rustbox/router/SYZYGY-breakout/README.md

# SYZYGY Breakout

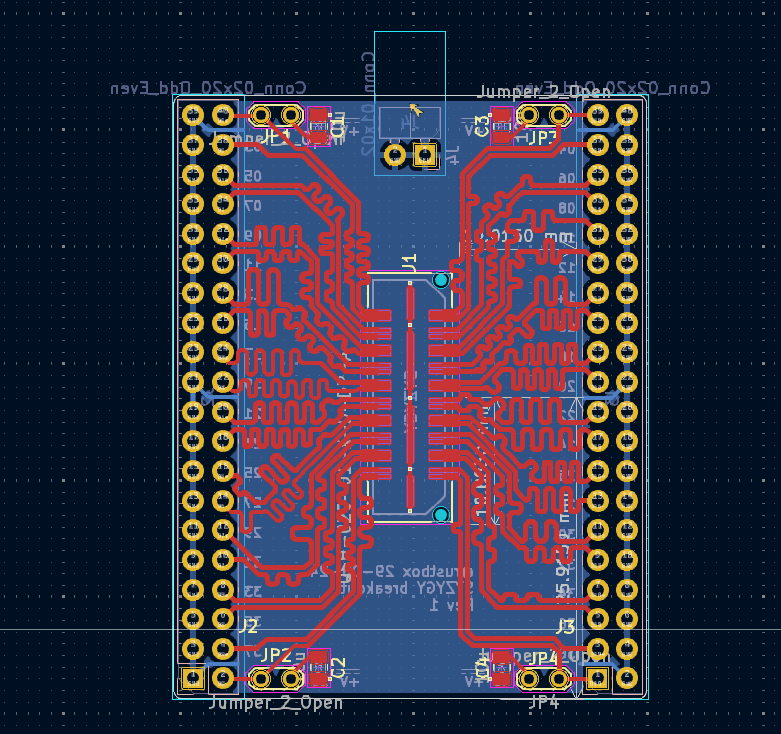
[picture p5: SYZYGY-breakout/images/SYZYGY-breakout-PCB.png]


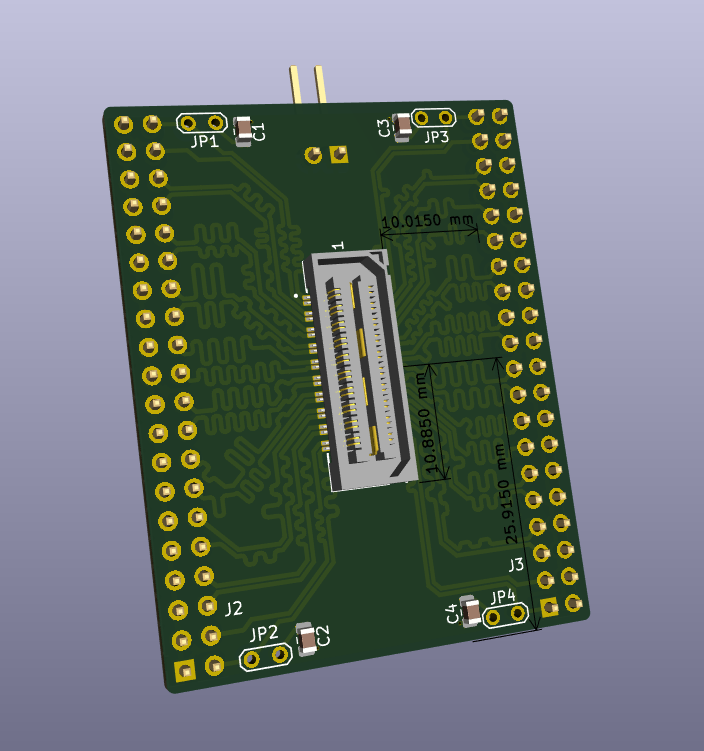
[picture p6: SYZYGY-breakout/images/SYZYGY-breakout-PCB-render.png]


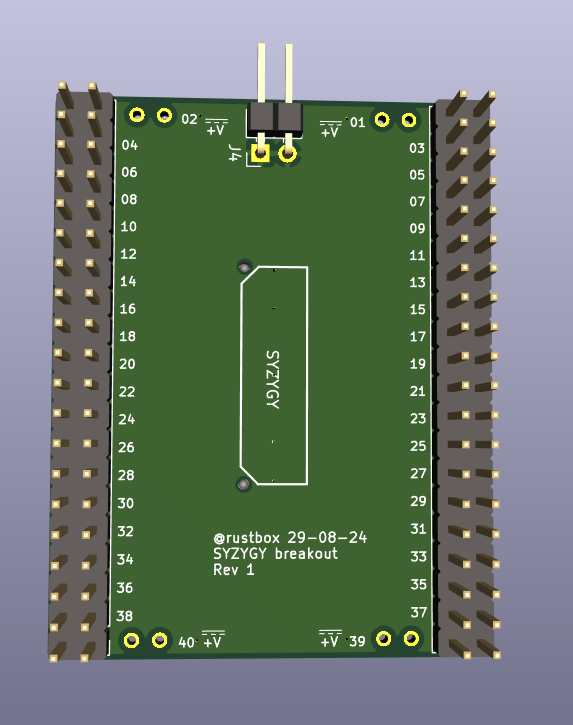
[picture p7: SYZYGY-breakout/images/SYZYGY-breakout-PCB-render-front.png]
