rustbox/router/HSEC8-109-01-L-RA-TR/HSEC8-109-01-L-RA-TR.step

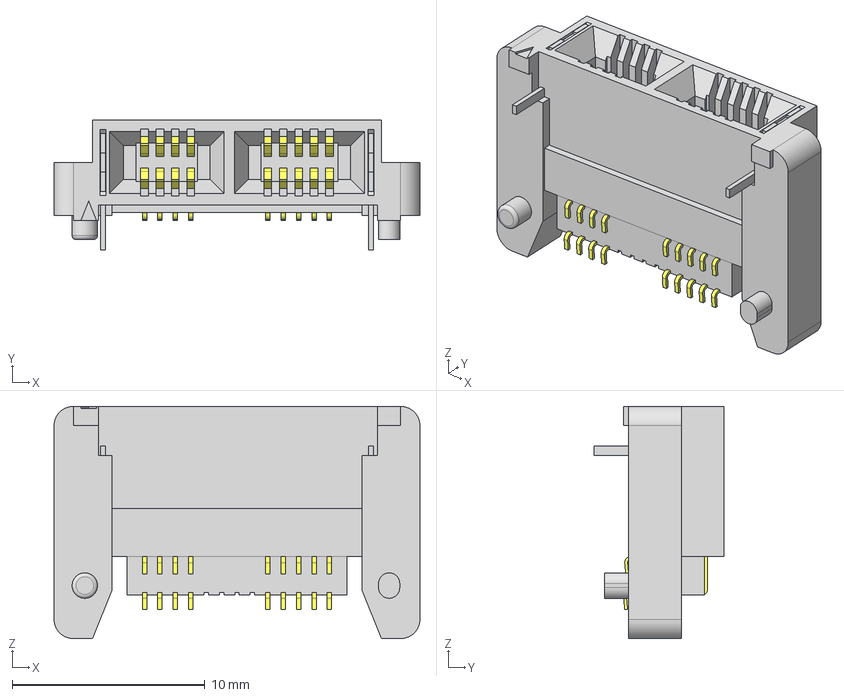
[picture p8: CAD file, 2024-07-10]
HSEC8-109-01-L-RA-TR/HSEC8-109-01-L-RA-TR.step
19.0 x 6.74 x 12.1 mm
HSEC8-09-01-D-RA-_socket
C-272-09
