rustbox/router/local/QSH-020-01-F-D-DP-A.stp

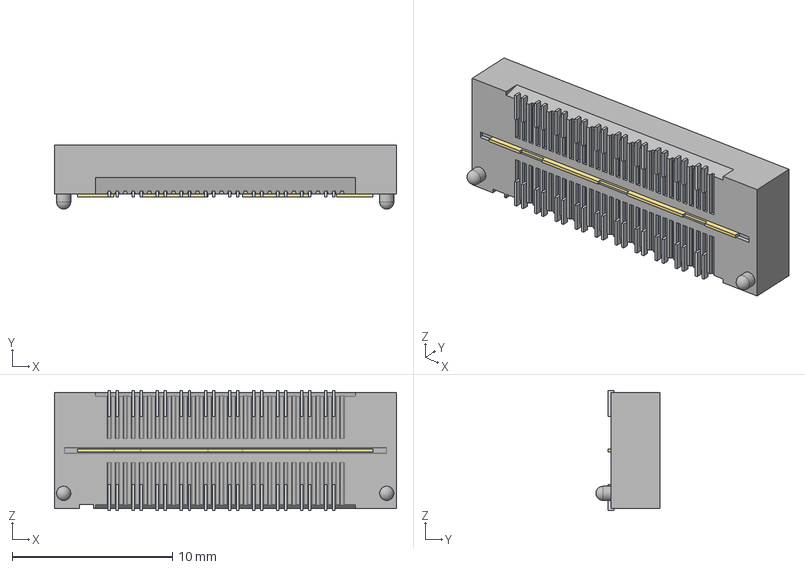
[picture p9: CAD file, 2024-08-29]
local/QSH-020-01-F-D-DP-A.stp
21.3 x 4.00 x 7.49 mm
TQSH-020-01-D-DP-A_terminal
T-1G2-01-020
C-126-21-020-D-DP-F
C-126-21-020-D-DP-F2
