rustbox/router/local/TXV0106BQBR.stp

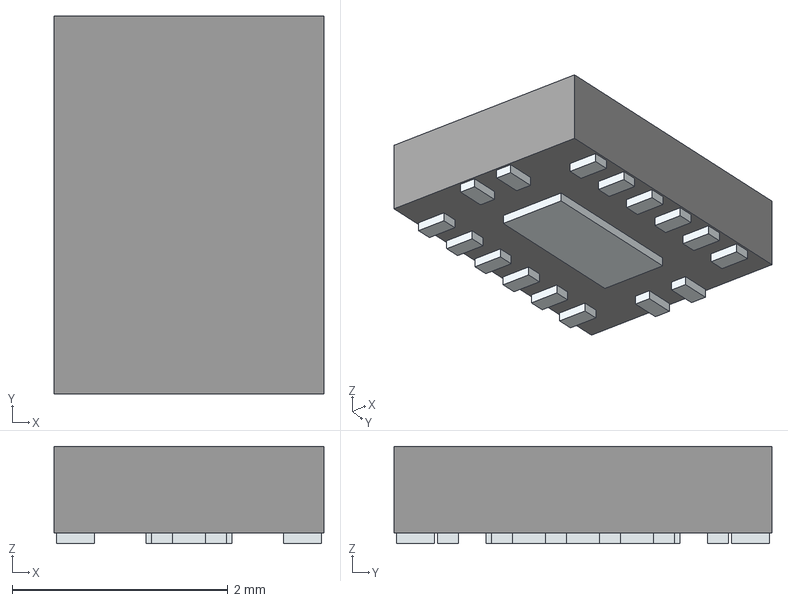
[picture p10: CAD file, 2024-08-16]
local/TXV0106BQBR.stp
2.50 x 3.50 x 0.9 mm
Pins
