rustbox/router/local/QTH-020-01-X-D-DP-A.step

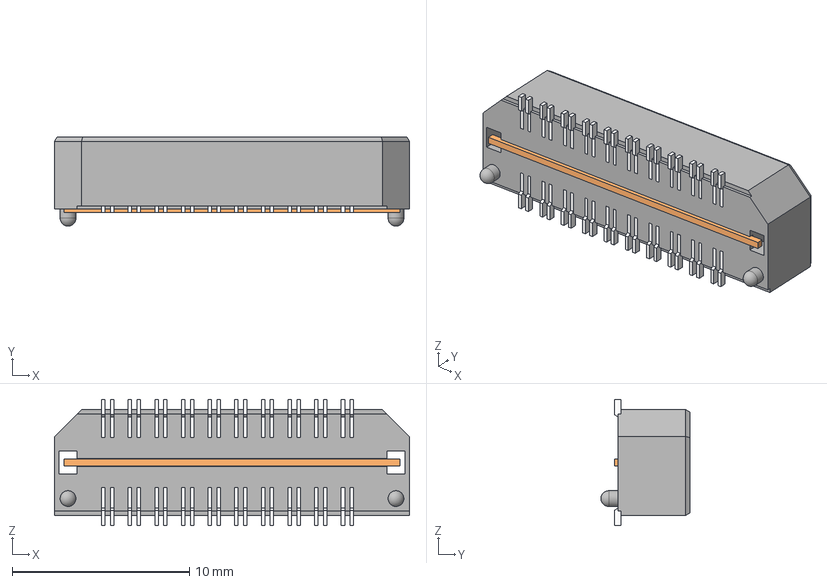
[picture p11: CAD file, 2024-08-07]
local/QTH-020-01-X-D-DP-A.step
20.0 x 5.03 x 7.11 mm
TQTH-020-01-F-D-DP-A_terminal
T-1S39-01(-020-01-D-DP-F)_pin
T-1S39-01(-020-01-D-DP)_pin2
T-1G1-01_imp
