rustbox/router/local/GPY111.stp

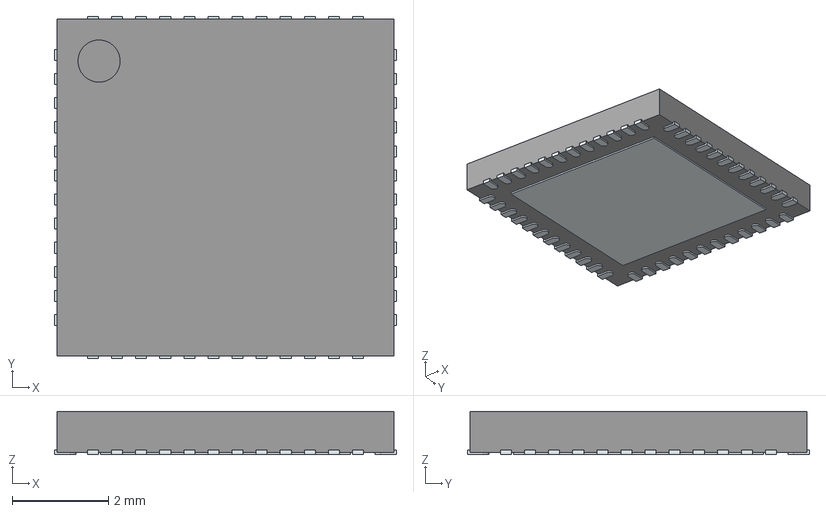
[picture p12: CAD file, 2024-08-07]
local/GPY111.stp
7.10 x 7.10 x 0.9 mm
ThermalPin
PinsArrayLR
PinsArrayTB
