rustbox/router/local/AP7363-HA-7.stp

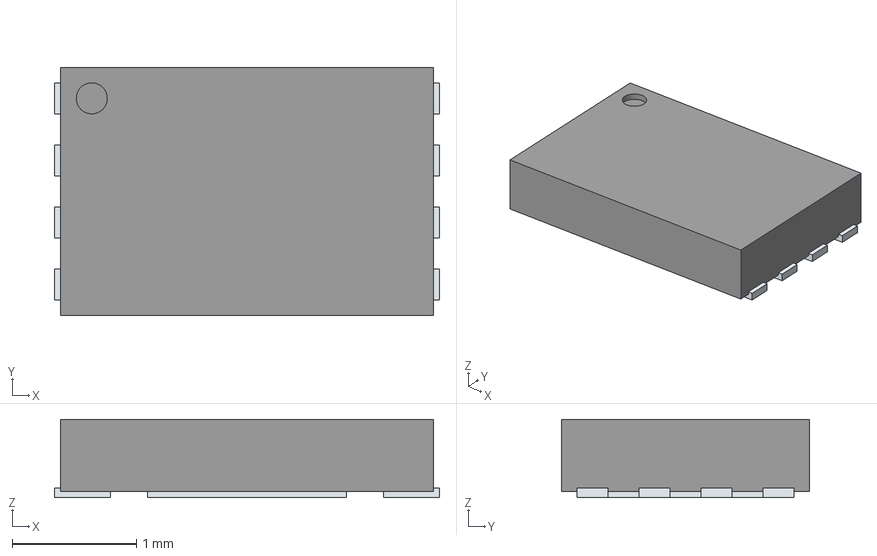
[picture p13: CAD file, 2024-08-07]
local/AP7363-HA-7.stp
3.10 x 2.00 x 0.63 mm
ThermalPin
PinsArrayLR
