rustbox/router/local/TS21-34-035-BK-160-SMT-TR.stp

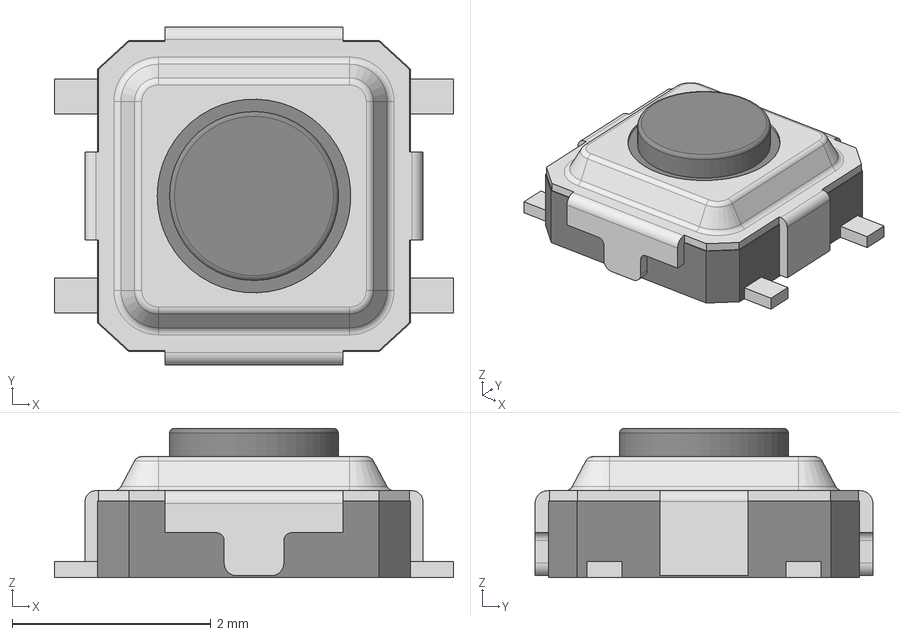
[picture p14: CAD file, 2024-07-10]
local/TS21-34-035-BK-160-SMT-TR.stp
4.02 x 3.40 x 1.50 mm
