rustbox/router/local/1149848.stp

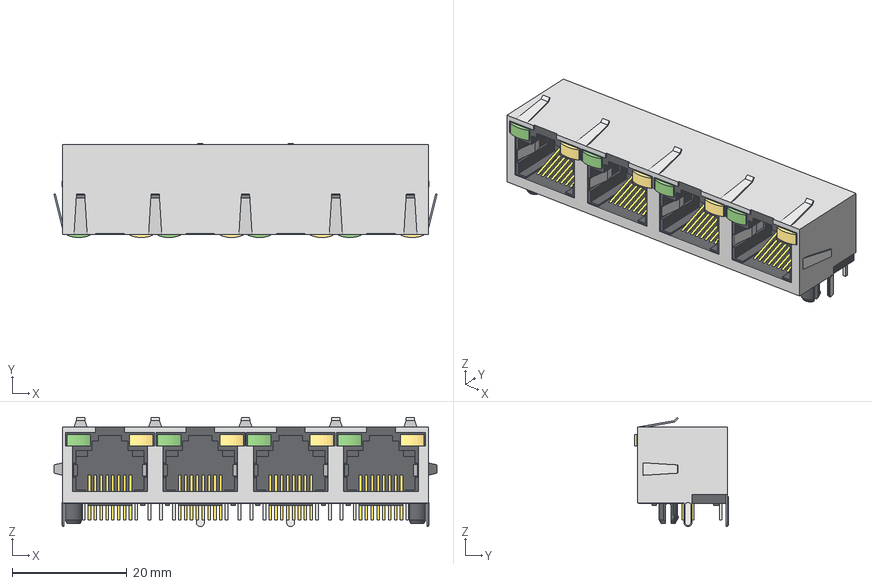
[picture p15: CAD file, 2024-07-10]
local/1149848.stp
66.8 x 16.4 x 19.0 mm
