rustbox/router/local/TPS564247DRLR.stp

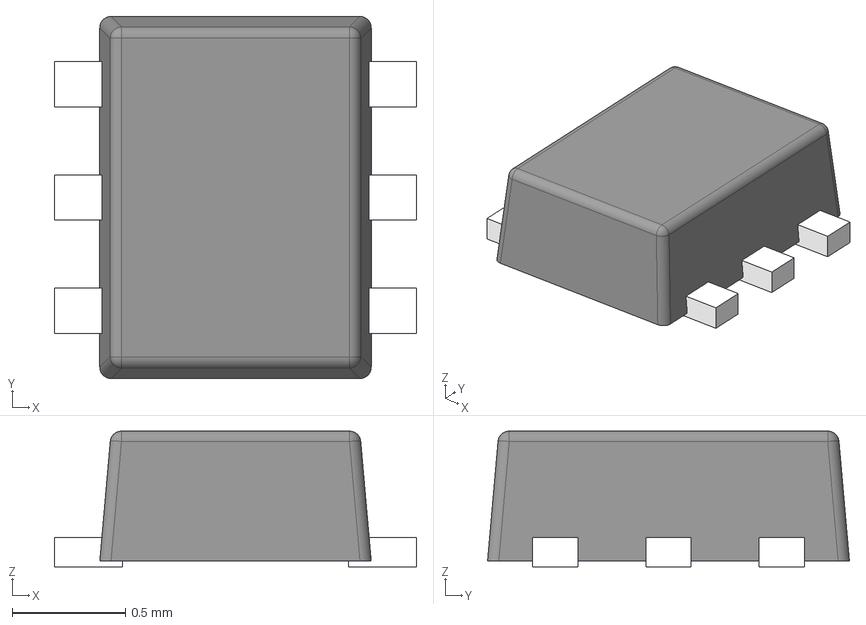
[picture p16: CAD file, 2024-07-10]
local/TPS564247DRLR.stp
1.60 x 1.60 x 0.6 mm
FRAME-DRL0006A
BODY-SOT
PIN1-ID
