rustbox/router/SYZYGY-PHY/SYZYGY-PHY-schematic.pdf

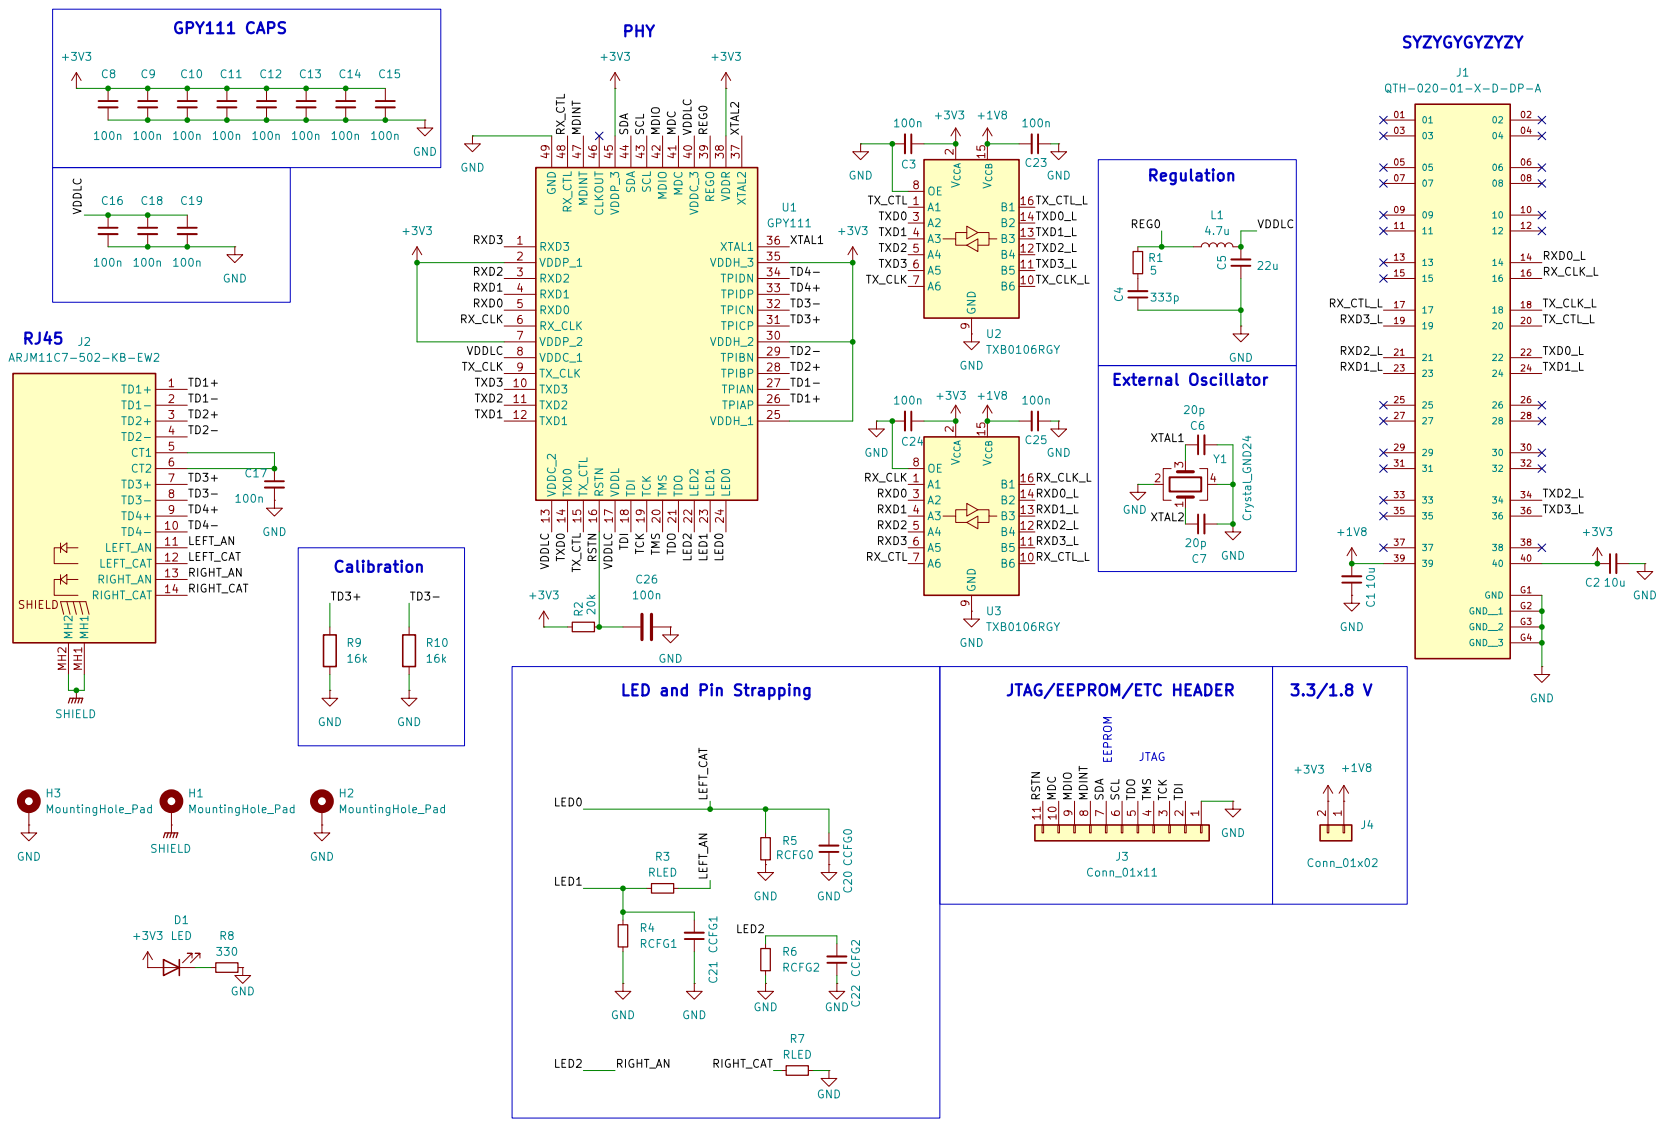
[picture p17: page 1]
