rustbox/router/SYZYGY-PHY/SYZYGY-PHY.kicad_pcb

## KiCad design SYZYGY-PHY/SYZYGY-PHY.kicad_pcb (2024-10-03)

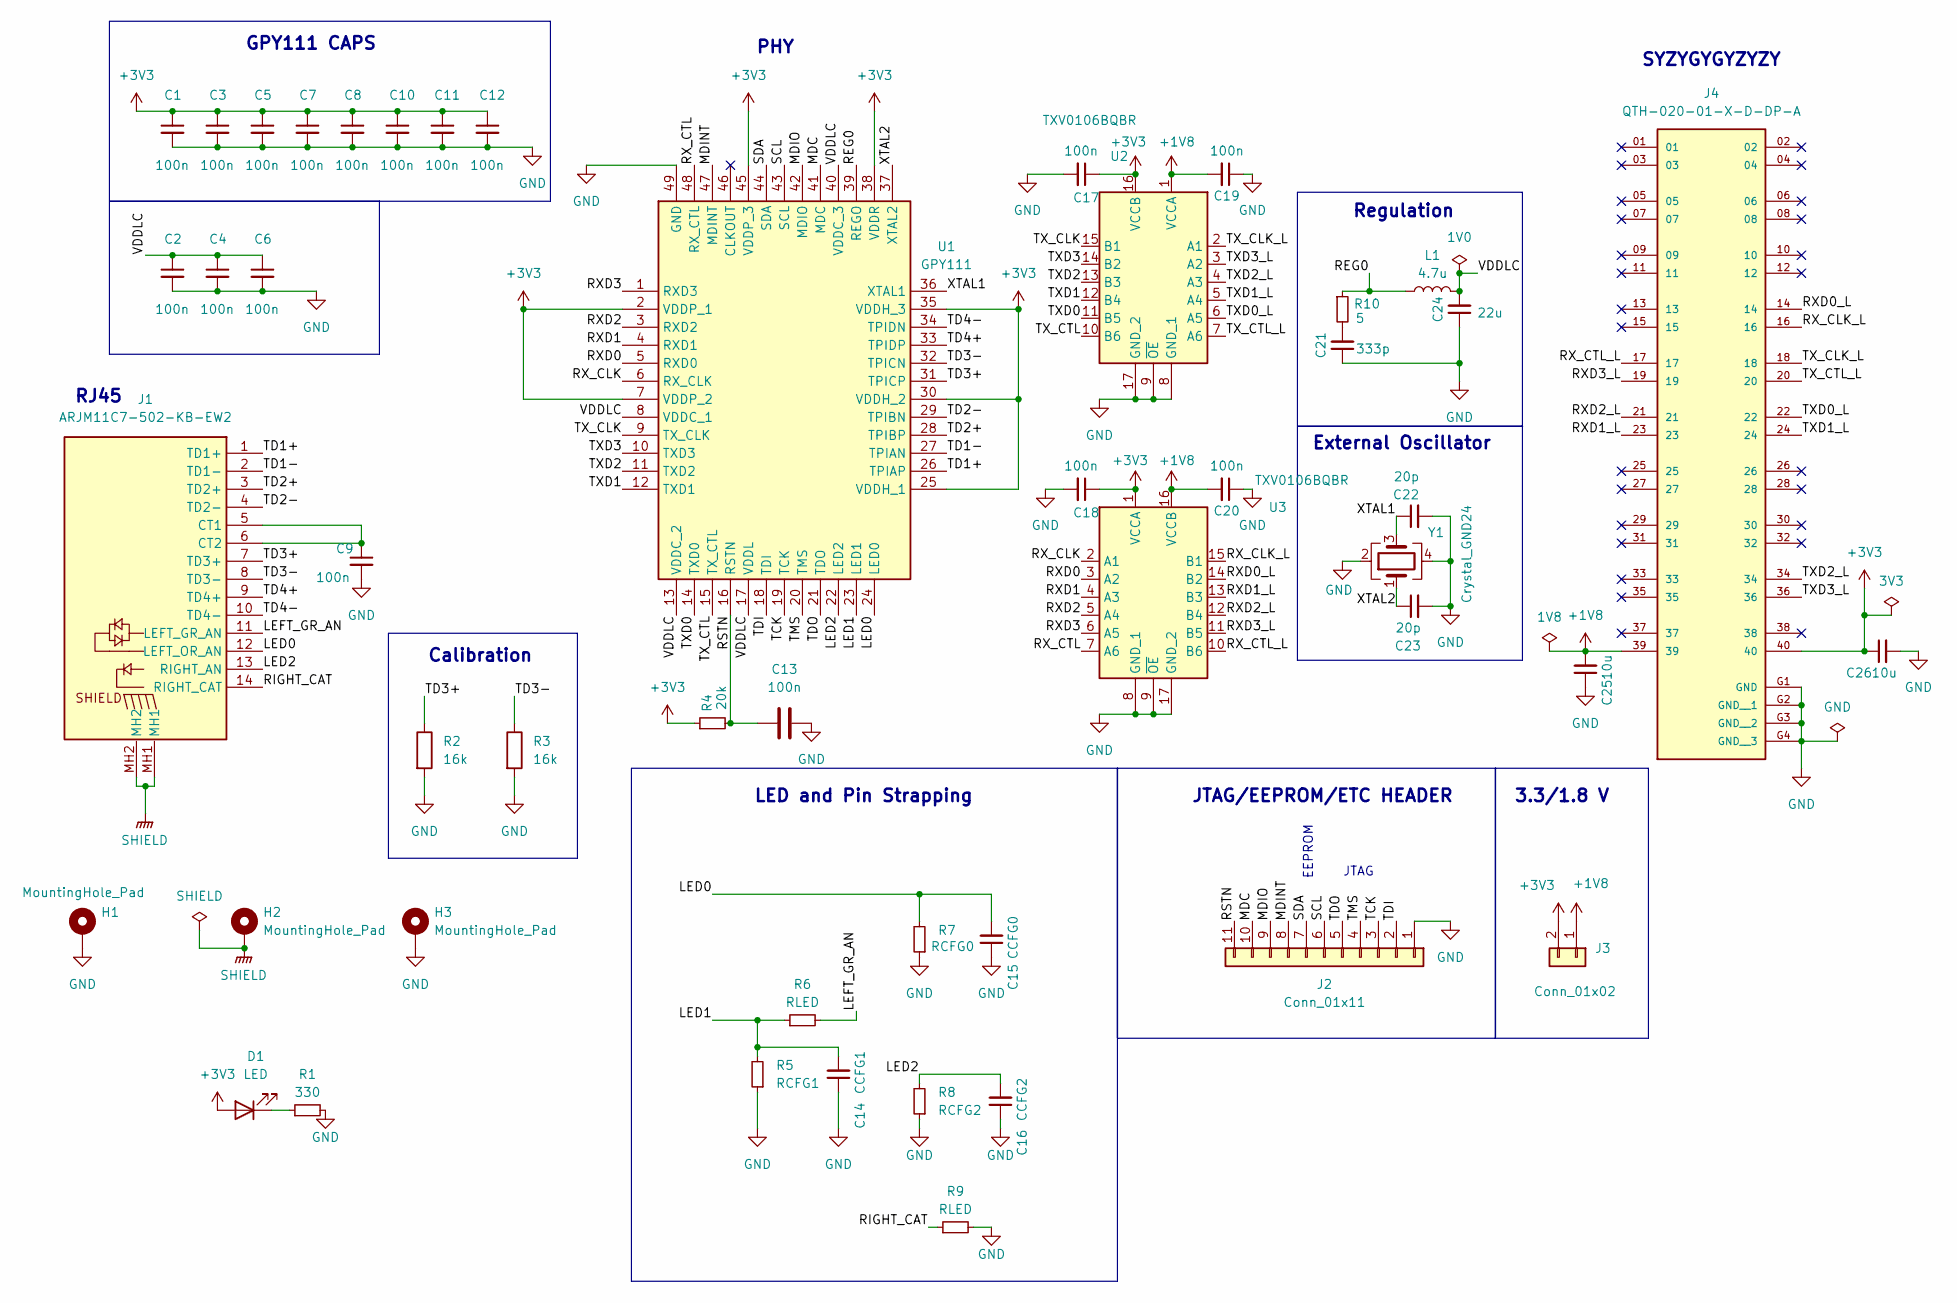
[picture p18: schematic SYZYGY-PHY.kicad_sch]

Parts:
C1, C2, C3, C4, C5, C6, C7, C8, C9, C10, C11, C12, C13, C17, C18, C19, C20: 100n; C_0805_2012Metric_Pad1.18x1.45mm_HandSolder
C14: CCFG1; C_0805_2012Metric_Pad1.18x1.45mm_HandSolder
C15: CCFG0; C_0805_2012Metric_Pad1.18x1.45mm_HandSolder
C16: CCFG2; C_0805_2012Metric_Pad1.18x1.45mm_HandSolder
C21: 333p; C_0805_2012Metric_Pad1.18x1.45mm_HandSolder
C22, C23: 20p; C_0805_2012Metric_Pad1.18x1.45mm_HandSolder
C24: 22u; C_0805_2012Metric_Pad1.18x1.45mm_HandSolder
C25, C26: 10u; C_0805_2012Metric_Pad1.18x1.45mm_HandSolder
D1: LED; LED_0805_2012Metric; Mouser # 710-150080VS75000
H1, H2, H3: MountingHole_Pad; MountingHole_2.7mm_M2.5_Pad
J1: ARJM11C7-502-KB-EW2; ARJM11C7502KBEW2; Mouser Part Number 815-RJM11C7502KBEW2
J2: Conn_01x11; PinSocket_1x11_P2.54mm_Vertical; Mouser # 538-22-15-2116
J3: Conn_01x02; PinHeader_1x02_P2.54mm_Vertical
J4: QTH-020-01-X-D-DP-A; SAMTEC_QTH-020-01-X-D-DP-A; PARTREV L; Mouser # 200-QTH02001LDDPA
L1: 4.7u; Inductor 0806 (2016 metric); Part MAKK2016T4R7M
R1: 330; R_0805_2012Metric_Pad1.20x1.40mm_HandSolder
R2: 16k; R_0805_2012Metric_Pad1.20x1.40mm_HandSolder; Mouser # 667-ERJ-6ENF1602V
R3: 16k; R_0805_2012Metric_Pad1.20x1.40mm_HandSolder
R4: 20k; R_0805_2012Metric_Pad1.20x1.40mm_HandSolder
R5: RCFG1; R_0805_2012Metric_Pad1.20x1.40mm_HandSolder
R6, R9: RLED; R_0805_2012Metric_Pad1.20x1.40mm_HandSolder
R7: RCFG0; R_0805_2012Metric_Pad1.20x1.40mm_HandSolder
R8: RCFG2; R_0805_2012Metric_Pad1.20x1.40mm_HandSolder
R10: 5; R_0805_2012Metric_Pad1.20x1.40mm_HandSolder
U1: GPY111; QFN50P700X700X90-49N-D; Mouser Part Number 701-GPY111
U2, U3: TXV0106BQBR; Mouser Part Number 595-TXV0106BQBR
Y1: Crystal_GND24; Crystal_SMD_3225-4Pin_3.2x2.5mm_HandSoldering; Manufacturer # TSX-3225 25.0000MF18X-G0; Mouser 732-TSX-322MF18X-G

Connections:
+1V8: C19.2, C20.2, C25.2, J3.1, J4.39, U2.1 (VCCA), U3.16 (VCCB)
+3V3: C1.1, C3.1, C5.1, C7.1, C8.1, C10.1, C11.1, C12.1, C17.1, C18.1, C26.1, D1.2 (A), J3.2, J4.40, R4.1, U1.2 (VDDP_1), U1.7 (VDDP_2), U1.25 (VDDH_1), U1.30 (VDDH_2), U1.35 (VDDH_3), U1.38 (VDDR), U1.45 (VDDP_3), U2.16 (VCCB), U3.1 (VCCA)
/LED0: C15.2, J1.12 (LEFT_OR_AN), R7.2, U1.24 (LED0)
/LED1: C14.2, R5.2, R6.1, U1.23 (LED1)
/LED2: C16.2, J1.13 (RIGHT_AN), R8.2, U1.22 (LED2)
/LEFT_GR_AN: J1.11 (LEFT_GR_AN), R6.2
/MDC: J2.10, U1.41 (MDC)
/MDINT: J2.8, U1.47 (MDINT)
/MDIO: J2.9, U1.42 (MDIO)
/REG0: L1.1, R10.1, U1.39 (REGO)
/RIGHT_CAT: J1.14 (RIGHT_CAT), R9.1
/RSTN: C13.2, J2.11, R4.2, U1.16 (RSTN)
/RXD0: U1.5 (RXD0), U3.3 (A2)
/RXD0_L: J4.14, U3.14 (B2)
/RXD1: U1.4 (RXD1), U3.4 (A3)
/RXD1_L: J4.23, U3.13 (B3)
/RXD2: U1.3 (RXD2), U3.5 (A4)
/RXD2_L: J4.21, U3.12 (B4)
/RXD3: U1.1 (RXD3), U3.6 (A5)
/RXD3_L: J4.19, U3.11 (B5)
/RX_CLK: U1.6 (RX_CLK), U3.2 (A1)
/RX_CLK_L: J4.16, U3.15 (B1)
/RX_CTL: U1.48 (RX_CTL), U3.7 (A6)
/RX_CTL_L: J4.17, U3.10 (B6)
/SCL: J2.6, U1.43 (SCL)
/SDA: J2.7, U1.44 (SDA)
/TCK: J2.3, U1.19 (TCK)
/TD1+: J1.1 (TD1+), U1.26 (TPIAP)
/TD1-: J1.2 (TD1-), U1.27 (TPIAN)
/TD2+: J1.3 (TD2+), U1.28 (TPIBP)
/TD2-: J1.4 (TD2-), U1.29 (TPIBN)
/TD3+: J1.7 (TD3+), R2.1, U1.31 (TPICP)
/TD3-: J1.8 (TD3-), R3.1, U1.32 (TPICN)
/TD4+: J1.9 (TD4+), U1.33 (TPIDP)
/TD4-: J1.10 (TD4-), U1.34 (TPIDN)
/TDI: J2.2, U1.18 (TDI)
/TDO: J2.5, U1.21 (TDO)
/TMS: J2.4, U1.20 (TMS)
/TXD0: U1.14 (TXD0), U2.11 (B5)
/TXD0_L: J4.22, U2.6 (A5)
/TXD1: U1.12 (TXD1), U2.12 (B4)
/TXD1_L: J4.24, U2.5 (A4)
/TXD2: U1.11 (TXD2), U2.13 (B3)
/TXD2_L: J4.34, U2.4 (A3)
/TXD3: U1.10 (TXD3), U2.14 (B2)
/TXD3_L: J4.36, U2.3 (A2)
/TX_CLK: U1.9 (TX_CLK), U2.15 (B1)
/TX_CLK_L: J4.18, U2.2 (A1)
/TX_CTL: U1.15 (TX_CTL), U2.10 (B6)
/TX_CTL_L: J4.20, U2.7 (A6)
/VDDLC: C2.1, C4.1, C6.1, C24.2, L1.2, U1.8 (VDDC_1), U1.13 (VDDC_2), U1.17 (VDDL), U1.40 (VDDC_3)
/XTAL1: C22.1, U1.36 (XTAL1), Y1.3
/XTAL2: C23.1, U1.37 (XTAL2), Y1.1
GND: C1.2, C2.2, C3.2, C4.2, C5.2, C6.2, C7.2, C8.2, C9.2, C10.2, C11.2, C12.2, C13.1, C14.1, C15.1, C16.1, C17.2, C18.2, C19.1, C20.1, C21.1, C22.2, C23.2, C24.1, C25.1, C26.2, H1.1, H3.1, J2.1, J4.G1 (GND), J4.G2 (GND__1), J4.G3 (GND__2), J4.G4 (GND__3), R1.2, R2.2, R3.2, R5.1, R7.1, R8.1, R9.2, U1.49 (GND), U2.8 (GND_1), U2.9 (~OE), U2.17 (GND_2), U3.8 (GND_1), U3.9 (~OE), U3.17 (GND_2), Y1.2, Y1.4
unnamed: C21.2, R10.2
unnamed: D1.1 (K), R1.1
unnamed: C9.1, J1.5 (CT1), J1.6 (CT2)
SHIELD: H2.1, J1.MH1, J1.MH2

Notes on the sheet:
JTAG/EEPROM/ETC HEADER
PHY
GPY111 CAPS
LED and Pin Strapping
RJ45
EEPROM
Regulation
Calibration
SYZYGYGYZYZY
3.3/1.8 V
JTAG
External Oscillator

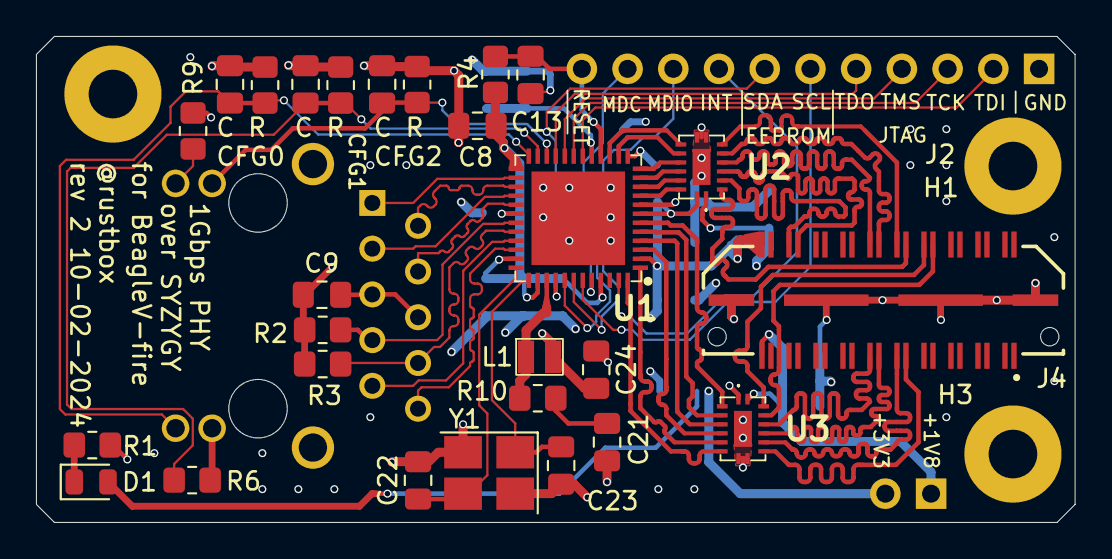
[picture p19: board SYZYGY-PHY.kicad_pcb from above]

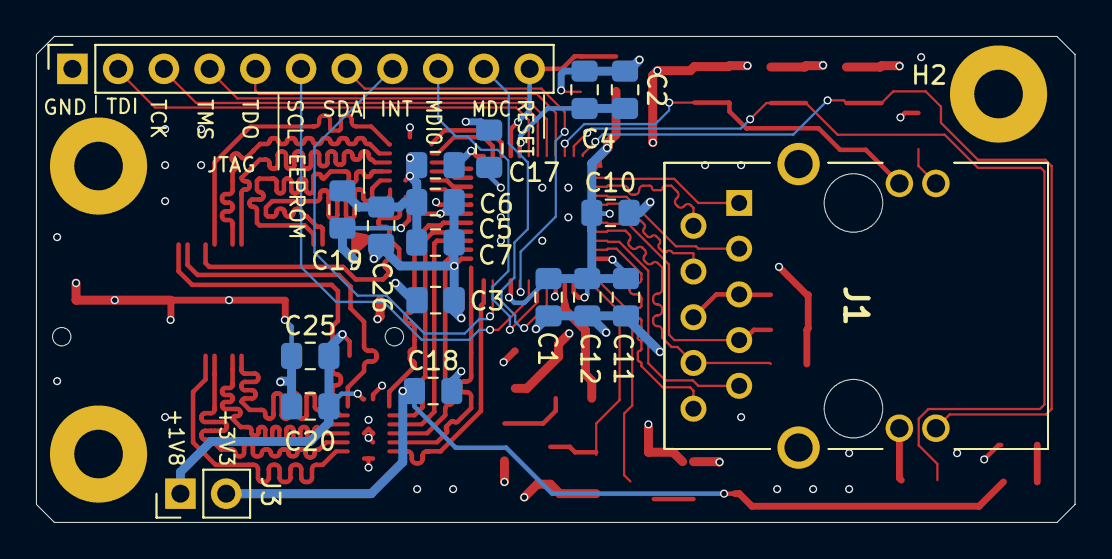
[picture p20: board SYZYGY-PHY.kicad_pcb from below]

Board: 4 copper layers, 57.7 x 27.0 mm, 49 parts (19 on the bottom side), 58 nets.
