rustbox/router/SYZYGY-RGMII-tester/SYZYGY-RGMII-tester.kicad_pcb

## KiCad design SYZYGY-RGMII-tester/SYZYGY-RGMII-tester.kicad_pcb (2024-10-03)

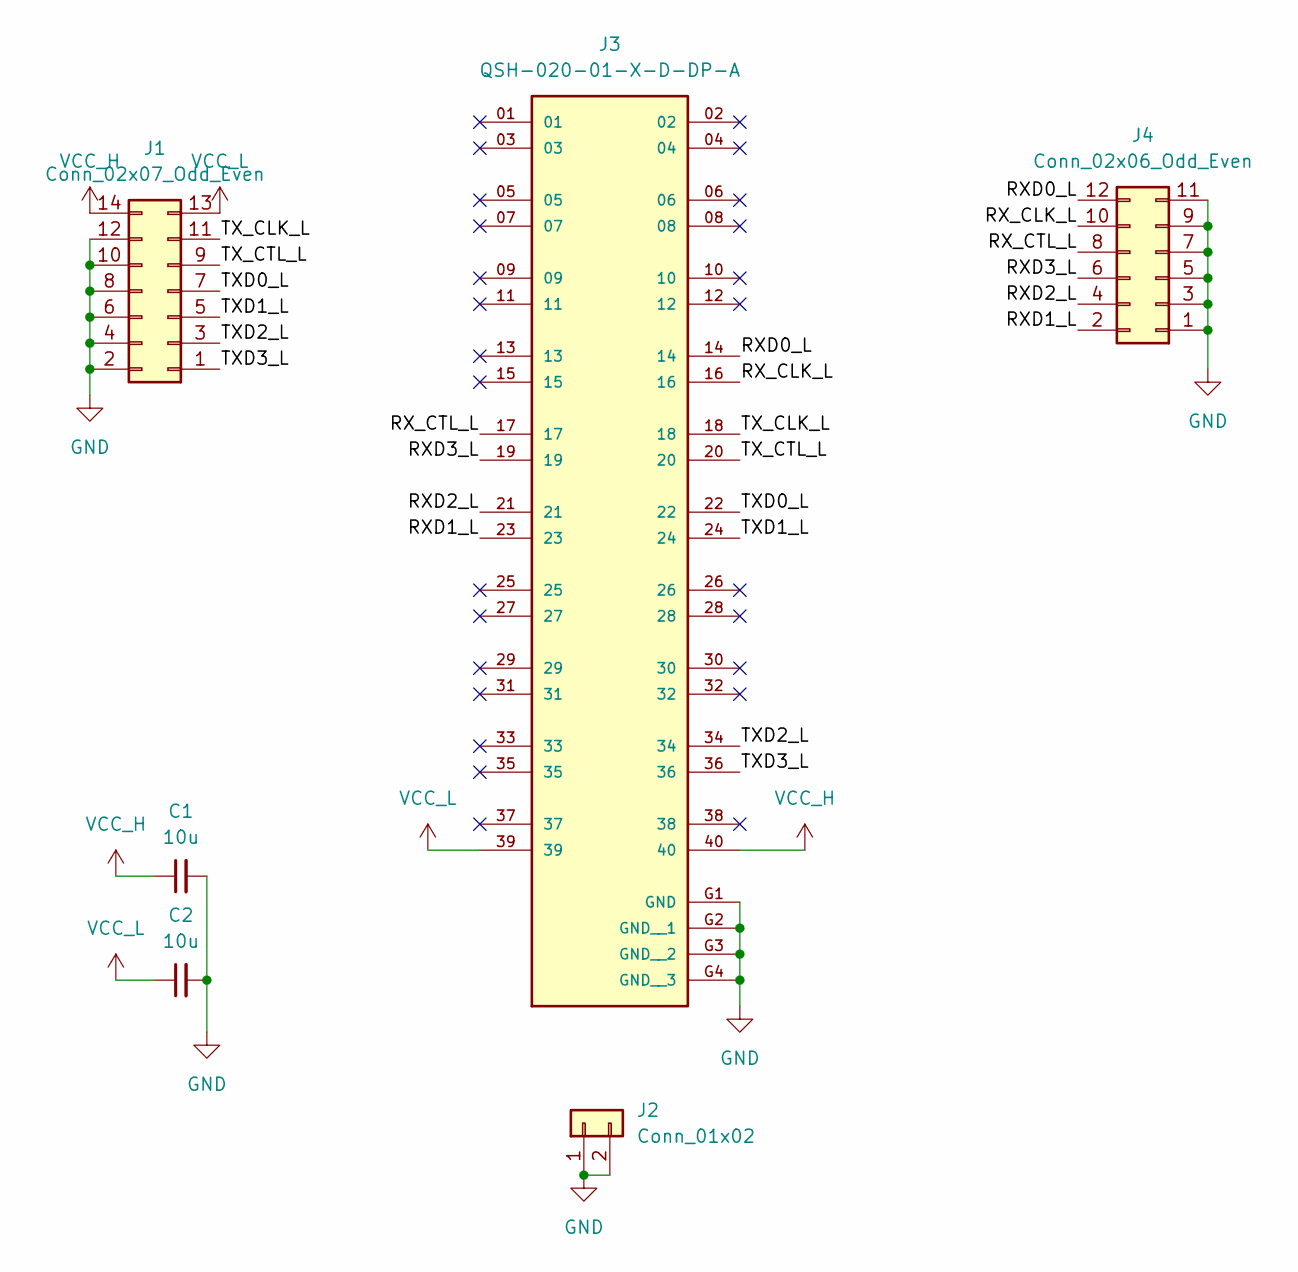
[picture p21: schematic SYZYGY-RGMII-tester.kicad_sch]

Parts:
C1, C2: 10u; C_0805_2012Metric
J1: Conn_02x07_Odd_Even; PinHeader_2x07_P2.54mm_Vertical
J2: Conn_01x02; PinHeader_1x02_P2.54mm_Horizontal
J3: QSH-020-01-X-D-DP-A; SAMTEC_QSH-020-01-X-D-DP-A; PARTREV M
J4: Conn_02x06_Odd_Even; PinHeader_2x06_P2.54mm_Vertical

Connections:
/RXD0_L: J3.14, J4.12
/RXD1_L: J3.23, J4.2
/RXD2_L: J3.21, J4.4
/RXD3_L: J3.19, J4.6
/RX_CLK_L: J3.16, J4.10
/RX_CTL_L: J3.17, J4.8
/TXD0_L: J1.7, J3.22
/TXD1_L: J1.5, J3.24
/TXD2_L: J1.3, J3.34
/TXD3_L: J1.1, J3.36
/TX_CLK_L: J1.11, J3.18
/TX_CTL_L: J1.9, J3.20
GND: C1.2, C2.2, J1.2, J1.4, J1.6, J1.8, J1.10, J1.12, J2.1, J2.2, J3.G1 (GND), J3.G2 (GND__1), J3.G3 (GND__2), J3.G4 (GND__3), J4.1, J4.3, J4.5, J4.7, J4.9, J4.11
VCC_H: C1.1, J1.14, J3.40
VCC_L: C2.1, J1.13, J3.39

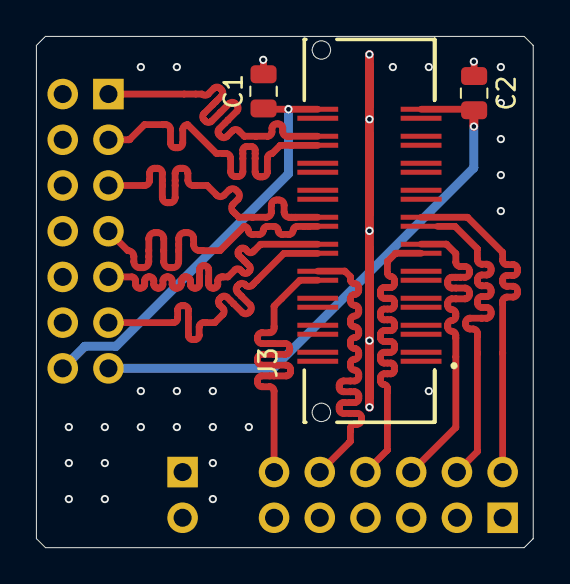
[picture p22: board SYZYGY-RGMII-tester.kicad_pcb from above]

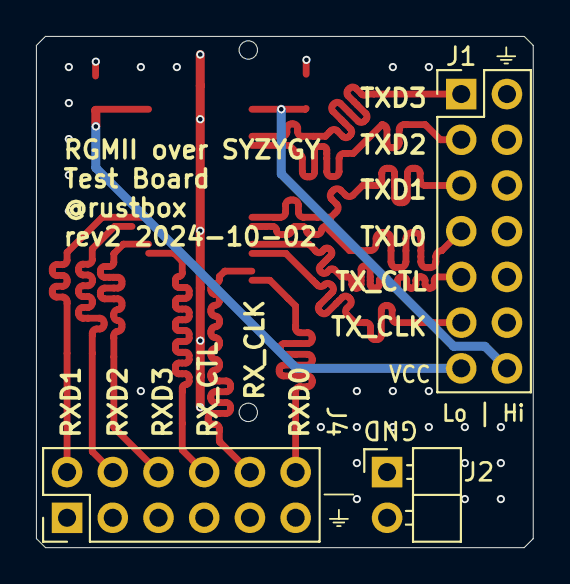
[picture p23: board SYZYGY-RGMII-tester.kicad_pcb from below]

Board: 4 copper layers, 27.6 x 28.4 mm, 6 parts (3 on the bottom side), 15 nets.
