rustbox/router/SYZYGY-breakout/SYZYGY-breakout.kicad_pcb

## KiCad design SYZYGY-breakout/SYZYGY-breakout.kicad_pcb (2024-08-29)

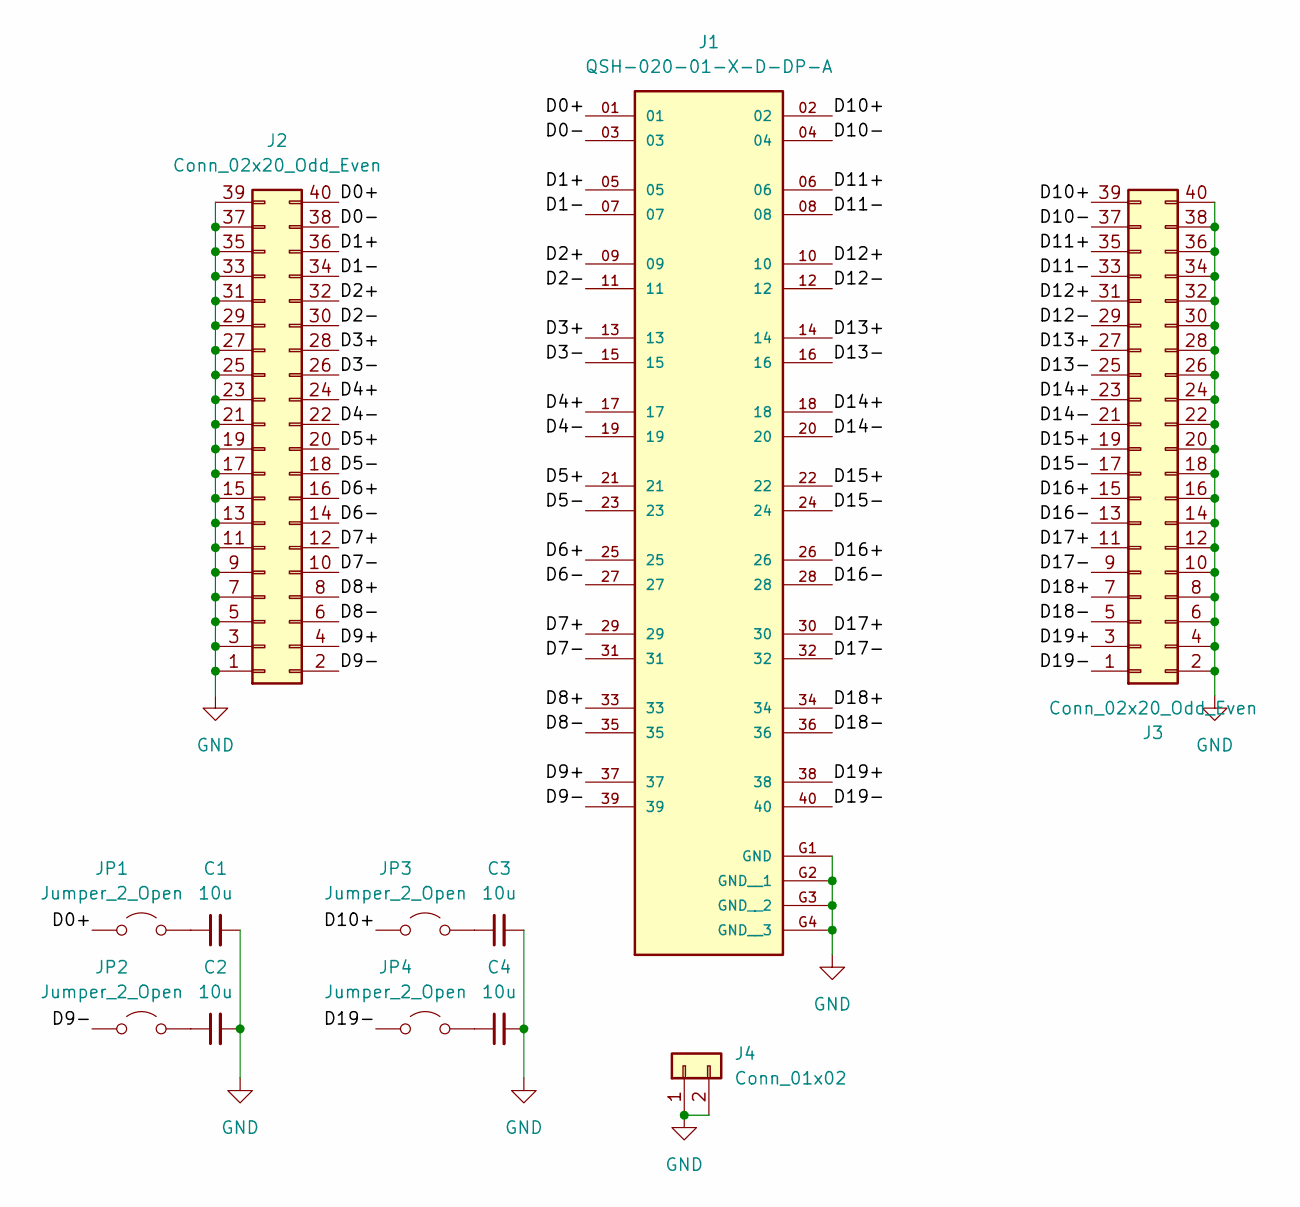
[picture p24: schematic SYZYGY-breakout.kicad_sch]

Parts:
C1, C2, C3, C4: 10u; C_0805_2012Metric
J1: QSH-020-01-X-D-DP-A; SAMTEC_QSH-020-01-X-D-DP-A; PARTREV M
J2, J3: Conn_02x20_Odd_Even; PinHeader_2x20_P2.54mm_Vertical
J4: Conn_01x02; PinHeader_1x02_P2.54mm_Horizontal
JP1, JP2, JP3, JP4: Jumper_2_Open; TestPoint_2Pads_Pitch2.54mm_Drill0.8mm

Connections:
/D0+: J1.01, J2.40, JP1.1 (A)
/D0-: J1.03, J2.38
/D1+: J1.05, J2.36
/D1-: J1.07, J2.34
/D2+: J1.09, J2.32
/D2-: J1.11, J2.30
/D3+: J1.13, J2.28
/D3-: J1.15, J2.26
/D4+: J1.17, J2.24
/D4-: J1.19, J2.22
/D5+: J1.21, J2.20
/D5-: J1.23, J2.18
/D6+: J1.25, J2.16
/D6-: J1.27, J2.14
/D7+: J1.29, J2.12
/D7-: J1.31, J2.10
/D8+: J1.33, J2.8
/D8-: J1.35, J2.6
/D9+: J1.37, J2.4
/D9-: J1.39, J2.2, JP2.1 (A)
/D10+: J1.02, J3.39, JP3.1 (A)
/D10-: J1.04, J3.37
/D11+: J1.06, J3.35
/D11-: J1.08, J3.33
/D12+: J1.10, J3.31
/D12-: J1.12, J3.29
/D13+: J1.14, J3.27
/D13-: J1.16, J3.25
/D14+: J1.18, J3.23
/D14-: J1.20, J3.21
/D15+: J1.22, J3.19
/D15-: J1.24, J3.17
/D16+: J1.26, J3.15
/D16-: J1.28, J3.13
/D17+: J1.30, J3.11
/D17-: J1.32, J3.9
/D18+: J1.34, J3.7
/D18-: J1.36, J3.5
/D19+: J1.38, J3.3
/D19-: J1.40, J3.1, JP4.1 (A)
GND: C1.2, C2.2, C3.2, C4.2, J1.G1 (GND), J1.G2 (GND__1), J1.G3 (GND__2), J1.G4 (GND__3), J2.1, J2.3, J2.5, J2.7, J2.9, J2.11, J2.13, J2.15, J2.17, J2.19, J2.21, J2.23, J2.25, J2.27, J2.29, J2.31, J2.33, J2.35, J2.37, J2.39, J3.2, J3.4, J3.6, J3.8, J3.10, J3.12, J3.14, J3.16, J3.18, J3.20, J3.22, J3.24, J3.26, J3.28, J3.30, J3.32, J3.34, J3.36, J3.38, J3.40, J4.1, J4.2
unnamed: C1.1, JP1.2 (B)
unnamed: C2.1, JP2.2 (B)
unnamed: C3.1, JP3.2 (B)
unnamed: C4.1, JP4.2 (B)

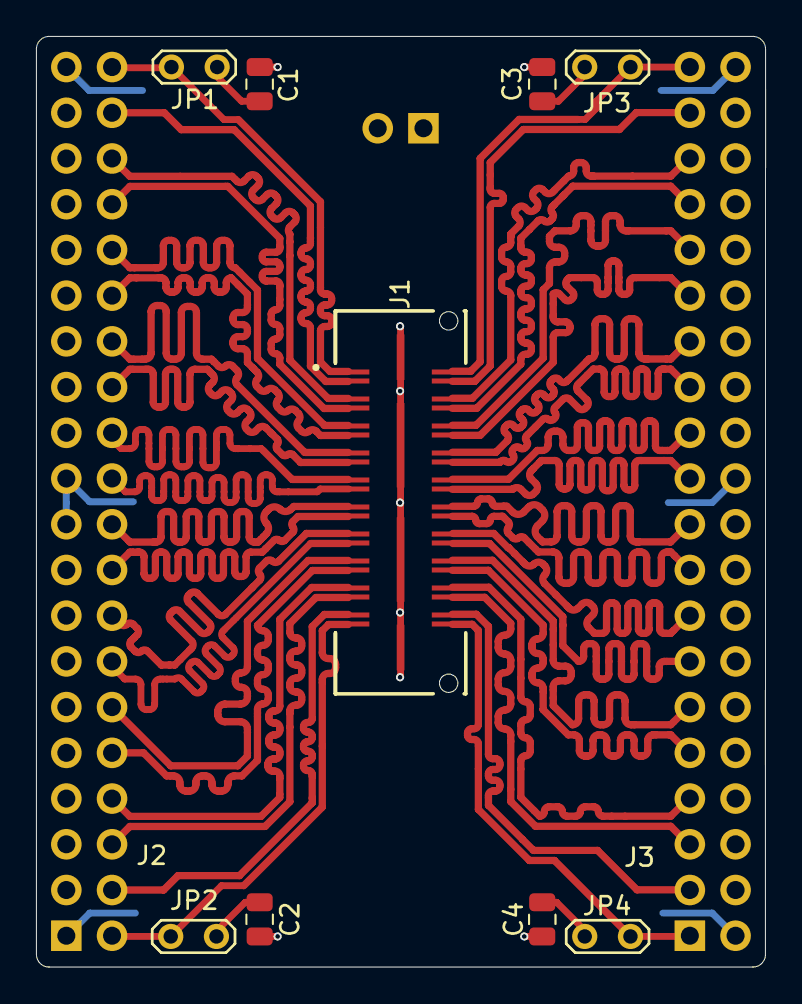
[picture p25: board SYZYGY-breakout.kicad_pcb from above]

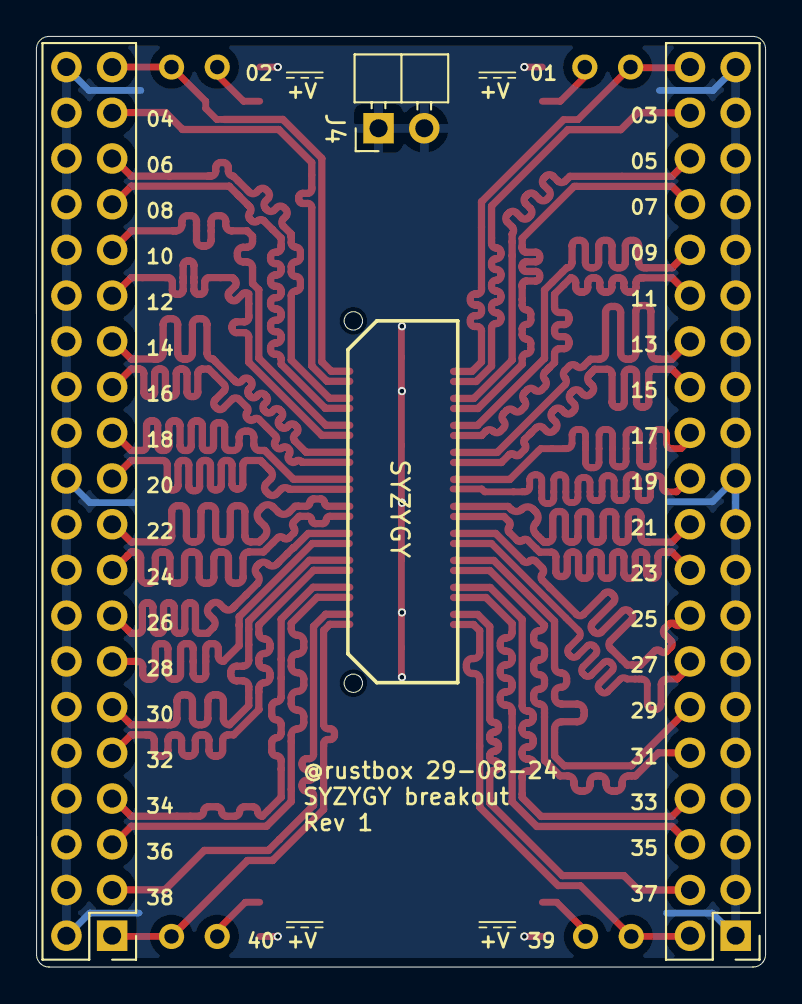
[picture p26: board SYZYGY-breakout.kicad_pcb from below]

Board: 2 copper layers, 40.5 x 51.7 mm, 12 parts (3 on the bottom side), 45 nets.
