rustbox/router/gsw141-breakout/gsw141-breakout.kicad_pcb

## KiCad design gsw141-breakout/gsw141-breakout.kicad_pcb (2024-08-16)

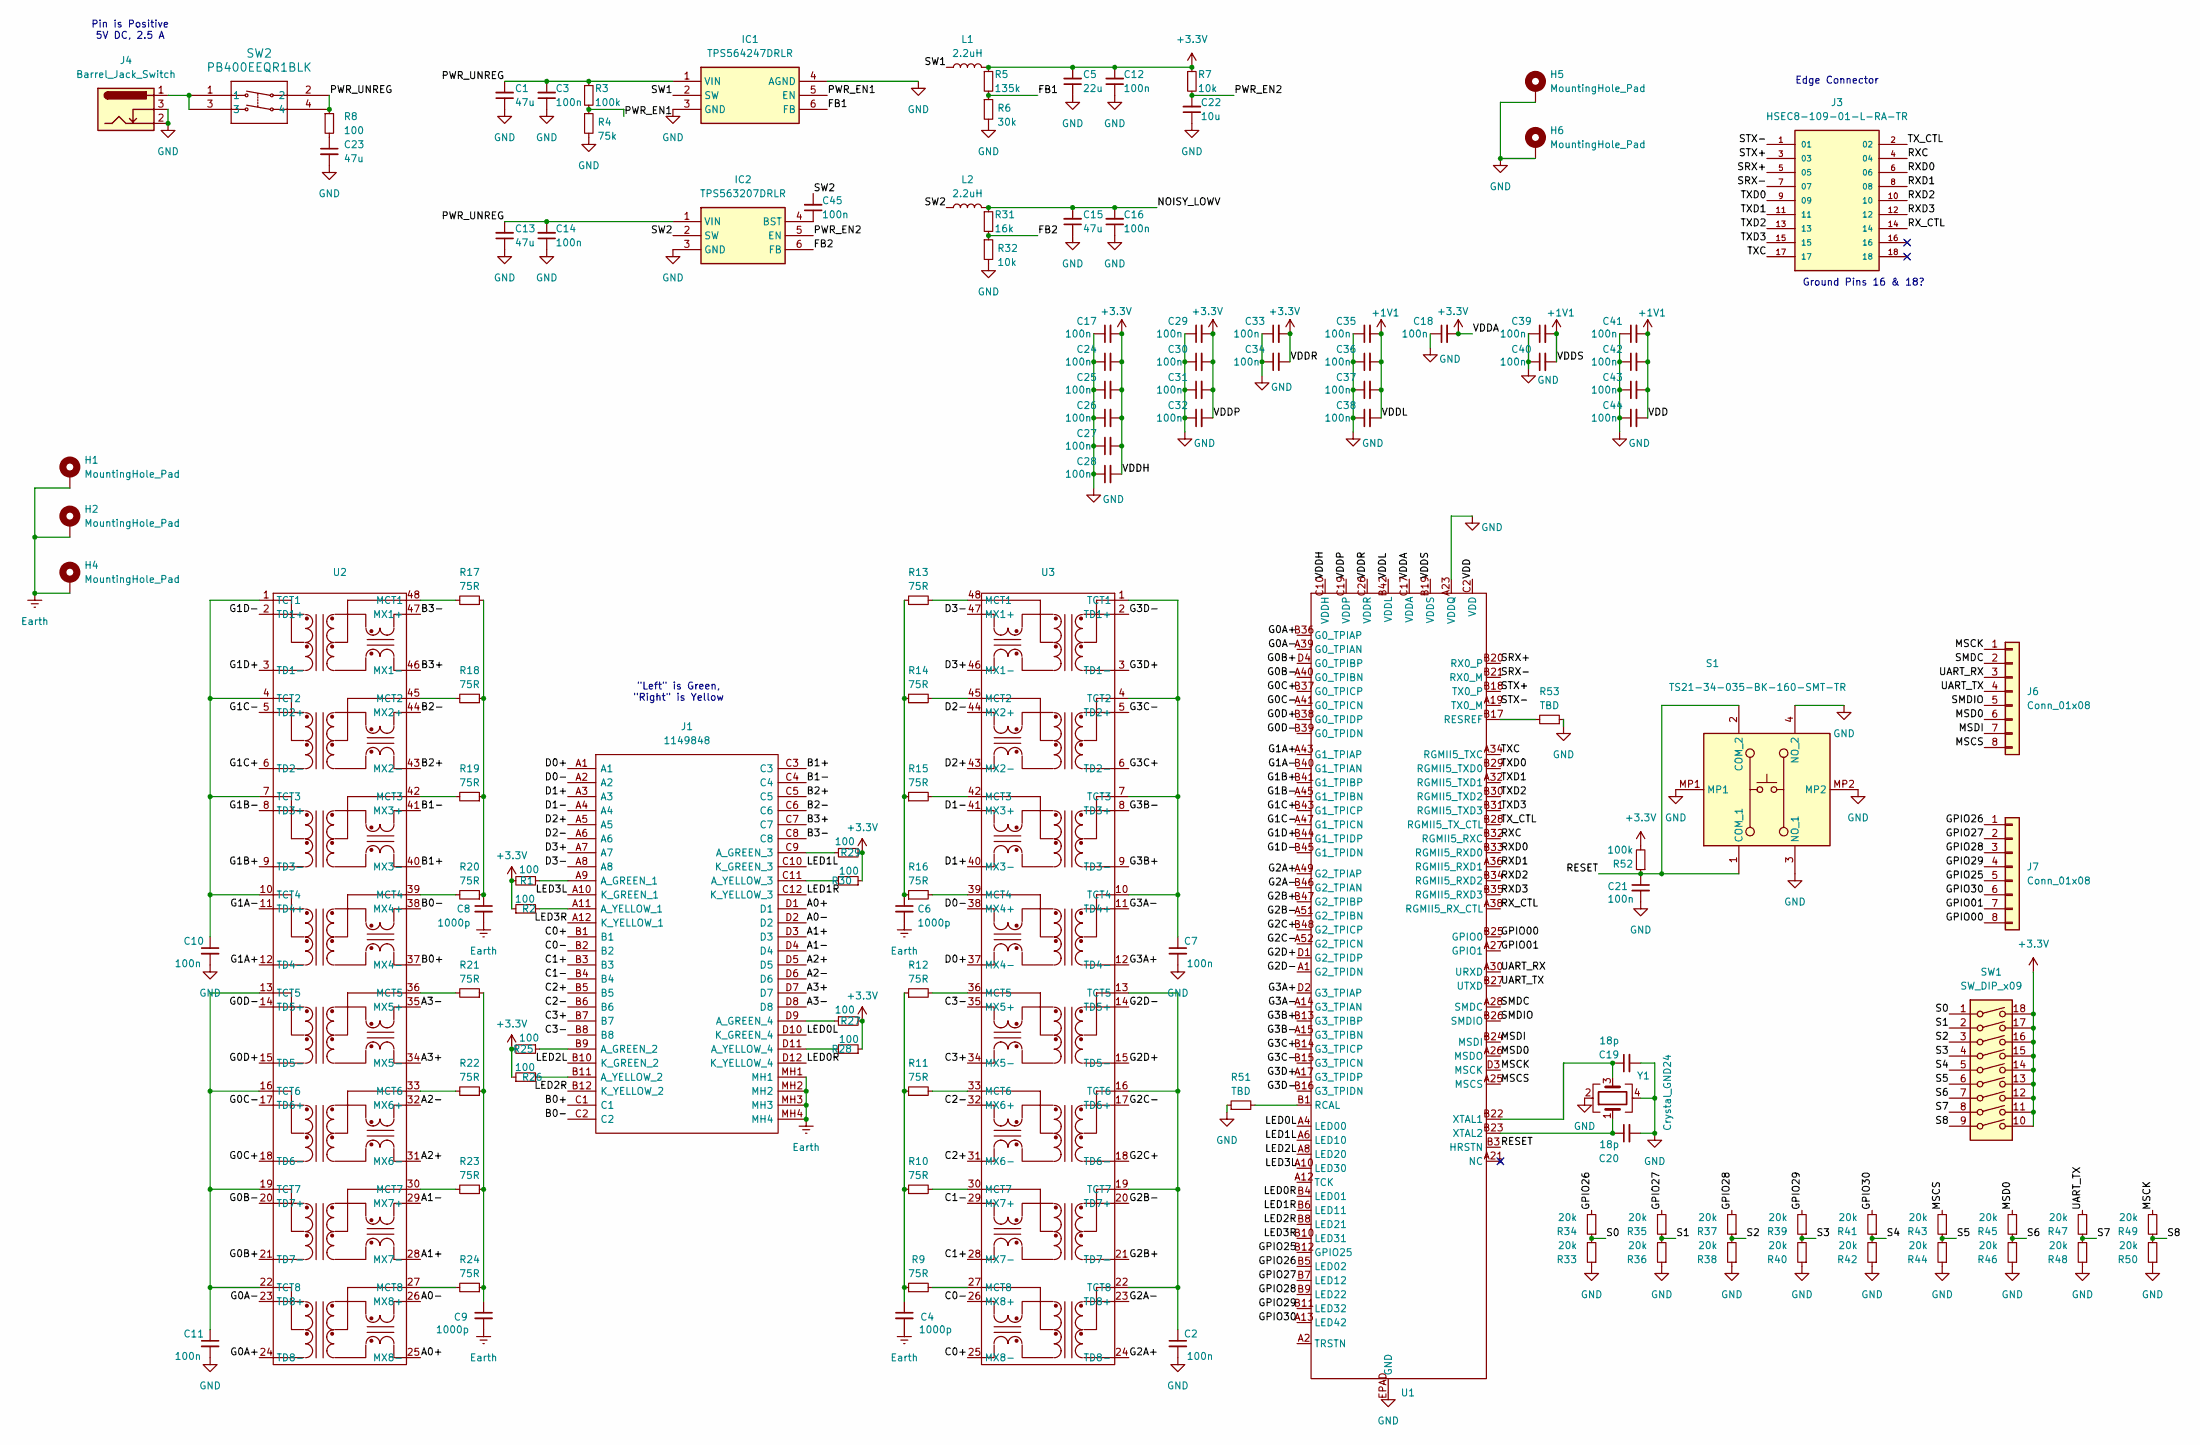
[picture p27: schematic gsw141-breakout.kicad_sch]

Parts:
C1, C13, C15, C23: 47u; C_0805_2012Metric_Pad1.18x1.45mm_HandSolder
C2, C3, C7, C10, C11, C12, C14, C16, C17, C18, C24, C25, C26, C27, C28, C29, C30, C31, C32, C33, C34, C35, C36, C37, C38, C39, C40, C41, C42, C43, C44, C45: 100n; C_0805_2012Metric_Pad1.18x1.45mm_HandSolder
C4, C6, C8, C9: 1000p; C_0805_2012Metric_Pad1.18x1.45mm_HandSolder
C5: 22u; C_0805_2012Metric_Pad1.18x1.45mm_HandSolder
C19, C20: 18p; C_0805_2012Metric
C21: 100n; C_0805_2012Metric
C22: 10u; C_0805_2012Metric_Pad1.18x1.45mm_HandSolder
H1, H2, H4, H5, H6: MountingHole_Pad; MountingHole_3.2mm_M3_Pad
IC1: TPS564247DRLR; SOTFL50P160X60-6N; Mouser Part Number 595-TPS564247DRLR
IC2: TPS563207DRLR; SOTFL50P160X60-6N; Mouser Part Number 595-TPS563207DRLR
J1: 1149848; Mouser Part Number 651-1149848
J3: HSEC8-109-01-L-RA-TR; Samtec_HSEC8-109-X-X-DV_2x09_P0.8mm_Edge; PARTREV Z
J4: Barrel_Jack_Switch; BarrelJack_Horizontal
J6, J7: Conn_01x08; PinHeader_1x08_P2.54mm_Vertical
L1, L2: 2.2uH; L_Abracon_ASPI-0425
R1, R2, R8, R25, R26, R27, R28, R29, R30: 100; R_0805_2012Metric_Pad1.20x1.40mm_HandSolder
R3, R52: 100k; R_0805_2012Metric_Pad1.20x1.40mm_HandSolder
R4: 75k; R_0805_2012Metric_Pad1.20x1.40mm_HandSolder
R5: 135k; R_0805_2012Metric_Pad1.20x1.40mm_HandSolder
R6: 30k; R_0805_2012Metric_Pad1.20x1.40mm_HandSolder
R7, R32: 10k; R_0805_2012Metric_Pad1.20x1.40mm_HandSolder
R9, R10, R11, R12, R13, R14, R15, R16, R17, R18, R19, R20, R21, R22, R23, R24: 75R; R_0805_2012Metric_Pad1.20x1.40mm_HandSolder
R31: 16k; R_0805_2012Metric_Pad1.20x1.40mm_HandSolder
R33, R34, R35, R36, R37, R38, R39, R40, R41, R42, R43, R44, R45, R46, R47, R48, R49, R50: 20k; R_0805_2012Metric_Pad1.20x1.40mm_HandSolder
R51, R53: TBD; R_0805_2012Metric_Pad1.20x1.40mm_HandSolder
S1: TS21-34-035-BK-160-SMT-TR; TS2134035BK160SMTTR; Mouser Part Number 179-134035BK160SMTTR
SW1: SW_DIP_x09; SW_DIP_SPSTx09_Slide_9.78x25.04mm_W7.62mm_P2.54mm
SW2: PB400EEQR1BLK; PB400EEQR1BLK_EWI
U1: XCVR_GSW140A3MC_S_LMHB
U2, U3: SMD-48
Y1: Crystal_GND24; Crystal_SMD_3225-4Pin_3.2x2.5mm_HandSoldering

Connections:
+1V1: C35.2, C36.2, C37.2, C38.2, C39.2, C40.2, C41.2, C42.2, C43.2, C44.2, U1.B19 (VDDS), U1.B42 (VDDL), U1.C2 (VDD), U1.C4 (VDD), U1.C12 (VDDL), U1.C15 (VDDS), U1.C23 (VDD), U1.C25 (VDD), U1.C33 (VDDL), U1.C37 (VDDL)
+3.3V: C5.2, C12.2, C17.2, C18.2, C24.2, C25.2, C26.2, C27.2, C28.2, C29.2, C30.2, C31.2, C32.2, C33.2, C34.2, L1.2, R1.2, R2.1, R5.1, R7.1, R25.2, R26.1, R27.2, R28.1, R29.2, R30.1, R52.2, SW1.10, SW1.11, SW1.12, SW1.13, SW1.14, SW1.15, SW1.16, SW1.17, SW1.18, U1.C6 (VDDP), U1.C8 (VDDP), U1.C10 (VDDH), U1.C14 (VDDH), U1.C17 (VDDA), U1.C19 (VDDP), U1.C21 (VDDP), U1.C26 (VDDR), U1.C28 (VDDR), U1.C31 (VDDH), U1.C34 (VDDH), U1.C36 (VDDH), U1.C39 (VDDH)
/A0+: J1.D1, U2.25 (MX8-)
/A0-: J1.D2, U2.26 (MX8+)
/A1+: J1.D3, U2.28 (MX7-)
/A1-: J1.D4, U2.29 (MX7+)
/A2+: J1.D5, U2.31 (MX6-)
/A2-: J1.D6, U2.32 (MX6+)
/A3+: J1.D7, U2.34 (MX5-)
/A3-: J1.D8, U2.35 (MX5+)
/B0+: J1.C1, U2.37 (MX4-)
/B0-: J1.C2, U2.38 (MX4+)
/B1+: J1.C3, U2.40 (MX3-)
/B1-: J1.C4, U2.41 (MX3+)
/B2+: J1.C5, U2.43 (MX2-)
/B2-: J1.C6, U2.44 (MX2+)
/B3+: J1.C7, U2.46 (MX1-)
/B3-: J1.C8, U2.47 (MX1+)
/C0+: J1.B1, U3.25 (MX8-)
/C0-: J1.B2, U3.26 (MX8+)
/C1+: J1.B3, U3.28 (MX7-)
/C1-: J1.B4, U3.29 (MX7+)
/C2+: J1.B5, U3.31 (MX6-)
/C2-: J1.B6, U3.32 (MX6+)
/C3+: J1.B7, U3.34 (MX5-)
/C3-: J1.B8, U3.35 (MX5+)
/D0+: J1.A1, U3.37 (MX4-)
/D0-: J1.A2, U3.38 (MX4+)
/D1+: J1.A3, U3.40 (MX3-)
/D1-: J1.A4, U3.41 (MX3+)
/D2+: J1.A5, U3.43 (MX2-)
/D2-: J1.A6, U3.44 (MX2+)
/D3+: J1.A7, U3.46 (MX1-)
/D3-: J1.A8, U3.47 (MX1+)
/FB1: IC1.6 (FB), R5.2, R6.1
/FB2: IC2.6 (FB), R31.2, R32.1
/G0A+: U1.B36 (G0_TPIAP), U2.24 (TD8-)
/G0A-: U1.A39 (G0_TPIAN), U2.23 (TD8+)
/G0B+: U1.D4 (G0_TPIBP), U2.21 (TD7-)
/G0B-: U1.A40 (G0_TPIBN), U2.20 (TD7+)
/G0C+: U1.B37 (G0_TPICP), U2.18 (TD6-)
/G0C-: U1.A41 (G0_TPICN), U2.17 (TD6+)
/G0D+: U1.B38 (G0_TPIDP), U2.15 (TD5-)
/G0D-: U1.B39 (G0_TPIDN), U2.14 (TD5+)
/G1A+: U1.A43 (G1_TPIAP), U2.12 (TD4-)
/G1A-: U1.B40 (G1_TPIAN), U2.11 (TD4+)
/G1B+: U1.B41 (G1_TPIBP), U2.9 (TD3-)
/G1B-: U1.A45 (G1_TPIBN), U2.8 (TD3+)
/G1C+: U1.B43 (G1_TPICP), U2.6 (TD2-)
/G1C-: U1.A47 (G1_TPICN), U2.5 (TD2+)
/G1D+: U1.B44 (G1_TPIDP), U2.3 (TD1-)
/G1D-: U1.B45 (G1_TPIDN), U2.2 (TD1+)
/G2A+: U1.A49 (G2_TPIAP), U3.24 (TD8-)
/G2A-: U1.B46 (G2_TPIAN), U3.23 (TD8+)
/G2B+: U1.B47 (G2_TPIBP), U3.21 (TD7-)
/G2B-: U1.A51 (G2_TPIBN), U3.20 (TD7+)
/G2C+: U1.B48 (G2_TPICP), U3.18 (TD6-)
/G2C-: U1.A52 (G2_TPICN), U3.17 (TD6+)
/G2D+: U1.D1 (G2_TPIDP), U3.15 (TD5-)
/G2D-: U1.A1 (G2_TPIDN), U3.14 (TD5+)
/G3A+: U1.D2 (G3_TPIAP), U3.12 (TD4-)
/G3A-: U1.A14 (G3_TPIAN), U3.11 (TD4+)
/G3B+: U1.B13 (G3_TPIBP), U3.9 (TD3-)
/G3B-: U1.A15 (G3_TPIBN), U3.8 (TD3+)
/G3C+: U1.B14 (G3_TPICP), U3.6 (TD2-)
/G3C-: U1.B15 (G3_TPICN), U3.5 (TD2+)
/G3D+: U1.A17 (G3_TPIDP), U3.3 (TD1-)
/G3D-: U1.B16 (G3_TPIDN), U3.2 (TD1+)
/GPIO00: J7.8, U1.B25 (GPIO0)
/GPIO01: J7.7, U1.A27 (GPIO1)
/GPIO25: J7.5, U1.B12 (GPIO25)
/GPIO26: J7.1, R34.2, U1.B5 (LED02)
/GPIO27: J7.2, R35.2, U1.B7 (LED12)
/GPIO28: J7.3, R37.2, U1.B9 (LED22)
/GPIO29: J7.4, R39.2, U1.B11 (LED32)
/GPIO30: J7.6, R41.2, U1.A13 (LED42)
/LED0L: J1.D10 (K_GREEN_4), U1.A4 (LED00)
/LED0R: J1.D12 (K_YELLOW_4), U1.B4 (LED01)
/LED1L: J1.C10 (K_GREEN_3), U1.A6 (LED10)
/LED1R: J1.C12 (K_YELLOW_3), U1.B6 (LED11)
/LED2L: J1.B10 (K_GREEN_2), U1.A8 (LED20)
/LED2R: J1.B12 (K_YELLOW_2), U1.B8 (LED21)
/LED3L: J1.A10 (K_GREEN_1), U1.A10 (LED30)
/LED3R: J1.A12 (K_YELLOW_1), U1.B10 (LED31)
/MSCK: J6.1, R49.2, U1.D3 (MSCK)
/MSCS: J6.8, R43.2, U1.A25 (MSCS)
/MSD0: J6.6, R45.2, U1.A26 (MSDO)
/MSDI: J6.7, U1.B24 (MSDI)
/NOISY_LOWV: C15.2, C16.2, L2.2, R31.1
/PWR_EN1: IC1.5 (EN), R3.2, R4.1
/PWR_EN2: C22.2, IC2.5 (EN), R7.2
/PWR_UNREG: C1.2, C3.2, C13.2, C14.2, IC1.1 (VIN), IC2.1 (VIN), R3.1, R8.1, SW2.2, SW2.4
/RESET: C21.1, R52.1, S1.1 (COM_1), S1.2 (COM_2), U1.B3 (HRSTN)
/RXC: J3.4, U1.B32 (RGMII5_RXC)
/RXD0: J3.6, U1.B33 (RGMII5_RXD0)
/RXD1: J3.8, U1.A36 (RGMII5_RXD1)
/RXD2: J3.10, U1.B34 (RGMII5_RXD2)
/RXD3: J3.12, U1.B35 (RGMII5_RXD3)
/RX_CTL: J3.14, U1.A38 (RGMII5_RX_CTL)
/S0: R33.2, R34.1, SW1.1
/S1: R35.1, R36.2, SW1.2
/S2: R37.1, R38.2, SW1.3
/S3: R39.1, R40.2, SW1.4
/S4: R41.1, R42.2, SW1.5
/S5: R43.1, R44.2, SW1.6
/S6: R45.1, R46.2, SW1.7
/S7: R47.1, R48.2, SW1.8
/S8: R49.1, R50.2, SW1.9
/SMDC: J6.2, U1.A28 (SMDC)
/SMDIO: J6.5, U1.B26 (SMDIO)
/SRX+: J3.5, U1.B20 (RX0_P)
/SRX-: J3.7, U1.B21 (RX0_M)
/STX+: J3.3, U1.B18 (TX0_P)
/STX-: J3.1, U1.A19 (TX0_M)
/SW1: IC1.2 (SW), L1.1
/SW2: C45.2, IC2.2 (SW), L2.1
/TXC: J3.17, U1.A34 (RGMII5_TXC)
/TXD0: J3.9, U1.B29 (RGMII5_TXD0)
/TXD1: J3.11, U1.A32 (RGMII5_TXD1)
/TXD2: J3.13, U1.B30 (RGMII5_TXD2)
/TXD3: J3.15, U1.B31 (RGMII5_TXD3)
/TX_CTL: J3.2, U1.B28 (RGMII5_TX_CTL)
/UART_RX: J6.3, U1.A30 (URXD)
/UART_TX: J6.4, R47.2, U1.B27 (UTXD)
Earth: C4.2, C6.2, C8.2, C9.2, H1.1, H2.1, H4.1, J1.MH1, J1.MH2, J1.MH3, J1.MH4
GND: C1.1, C2.2, C3.1, C5.1, C7.2, C10.2, C11.2, C12.1, C13.1, C14.1, C15.1, C16.1, C17.1, C18.1, C19.2, C20.2, C21.2, C22.1, C23.2, C24.1, C25.1, C26.1, C27.1, C28.1, C29.1, C30.1, C31.1, C32.1, C33.1, C34.1, C35.1, C36.1, C37.1, C38.1, C39.1, C40.1, C41.1, C42.1, C43.1, C44.1, H5.1, H6.1, IC1.3 (GND), IC1.4 (AGND), IC2.3 (GND), J4.2, J4.3, R4.2, R6.2, R32.2, R33.1, R36.1, R38.1, R40.1, R42.1, R44.1, R46.1, R48.1, R50.1, R51.1, R53.1, S1.3 (NO_1), S1.4 (NO_2), S1.MP1, S1.MP2, U1.A23 (VDDQ), U1.EPAD (GND), Y1.2, Y1.4
unnamed: C4.1, R9.1, R10.1, R11.1, R12.1
unnamed: C6.1, R13.1, R14.1, R15.1, R16.1
unnamed: C8.1, R17.1, R18.1, R19.1, R20.1
unnamed: C9.1, R21.1, R22.1, R23.1, R24.1
unnamed: C23.1, R8.2
unnamed: C45.1, IC2.4 (BST)
unnamed: J1.A9 (A_GREEN_1), R1.1
unnamed: J1.B9 (A_GREEN_2), R25.1
unnamed: J1.C9 (A_GREEN_3), R29.1
unnamed: J1.D9 (A_GREEN_4), R27.1
unnamed: J1.A11 (A_YELLOW_1), R2.2
unnamed: J1.B11 (A_YELLOW_2), R26.2
unnamed: J1.C11 (A_YELLOW_3), R30.2
unnamed: J1.D11 (A_YELLOW_4), R28.2
unnamed: J4.1, SW2.1, SW2.3
unnamed: R51.2, U1.B1 (RCAL)
unnamed: R53.2, U1.B17 (RESREF)
unnamed: C19.1, U1.B22 (XTAL1), Y1.3
unnamed: C20.1, U1.B23 (XTAL2), Y1.1
unnamed: R17.2, U2.48 (MCT1)
unnamed: R18.2, U2.45 (MCT2)
unnamed: R19.2, U2.42 (MCT3)
unnamed: R20.2, U2.39 (MCT4)
unnamed: R21.2, U2.36 (MCT5)
unnamed: R22.2, U2.33 (MCT6)
unnamed: R23.2, U2.30 (MCT7)
unnamed: R24.2, U2.27 (MCT8)
unnamed: C10.1, U2.1 (TCT1), U2.4 (TCT2), U2.7 (TCT3), U2.10 (TCT4)
unnamed: C11.1, U2.13 (TCT5), U2.16 (TCT6), U2.19 (TCT7), U2.22 (TCT8)
unnamed: R13.2, U3.48 (MCT1)
unnamed: R14.2, U3.45 (MCT2)
unnamed: R15.2, U3.42 (MCT3)
unnamed: R16.2, U3.39 (MCT4)
unnamed: R12.2, U3.36 (MCT5)
unnamed: R11.2, U3.33 (MCT6)
unnamed: R10.2, U3.30 (MCT7)
unnamed: R9.2, U3.27 (MCT8)
unnamed: C7.1, U3.1 (TCT1), U3.4 (TCT2), U3.7 (TCT3), U3.10 (TCT4)
unnamed: C2.1, U3.13 (TCT5), U3.16 (TCT6), U3.19 (TCT7), U3.22 (TCT8)

Notes on the sheet:
Ground Pins 16 & 18?
Edge Connector
Pin is Positive 5V DC, 2.5 A
"Left" is Green, "Right" is Yellow
