rustbox/router/gsw141-breakout/gsw141-breakout.kicad_pcb

## KiCad design gsw141-breakout/gsw141-breakout.kicad_pcb (continued)

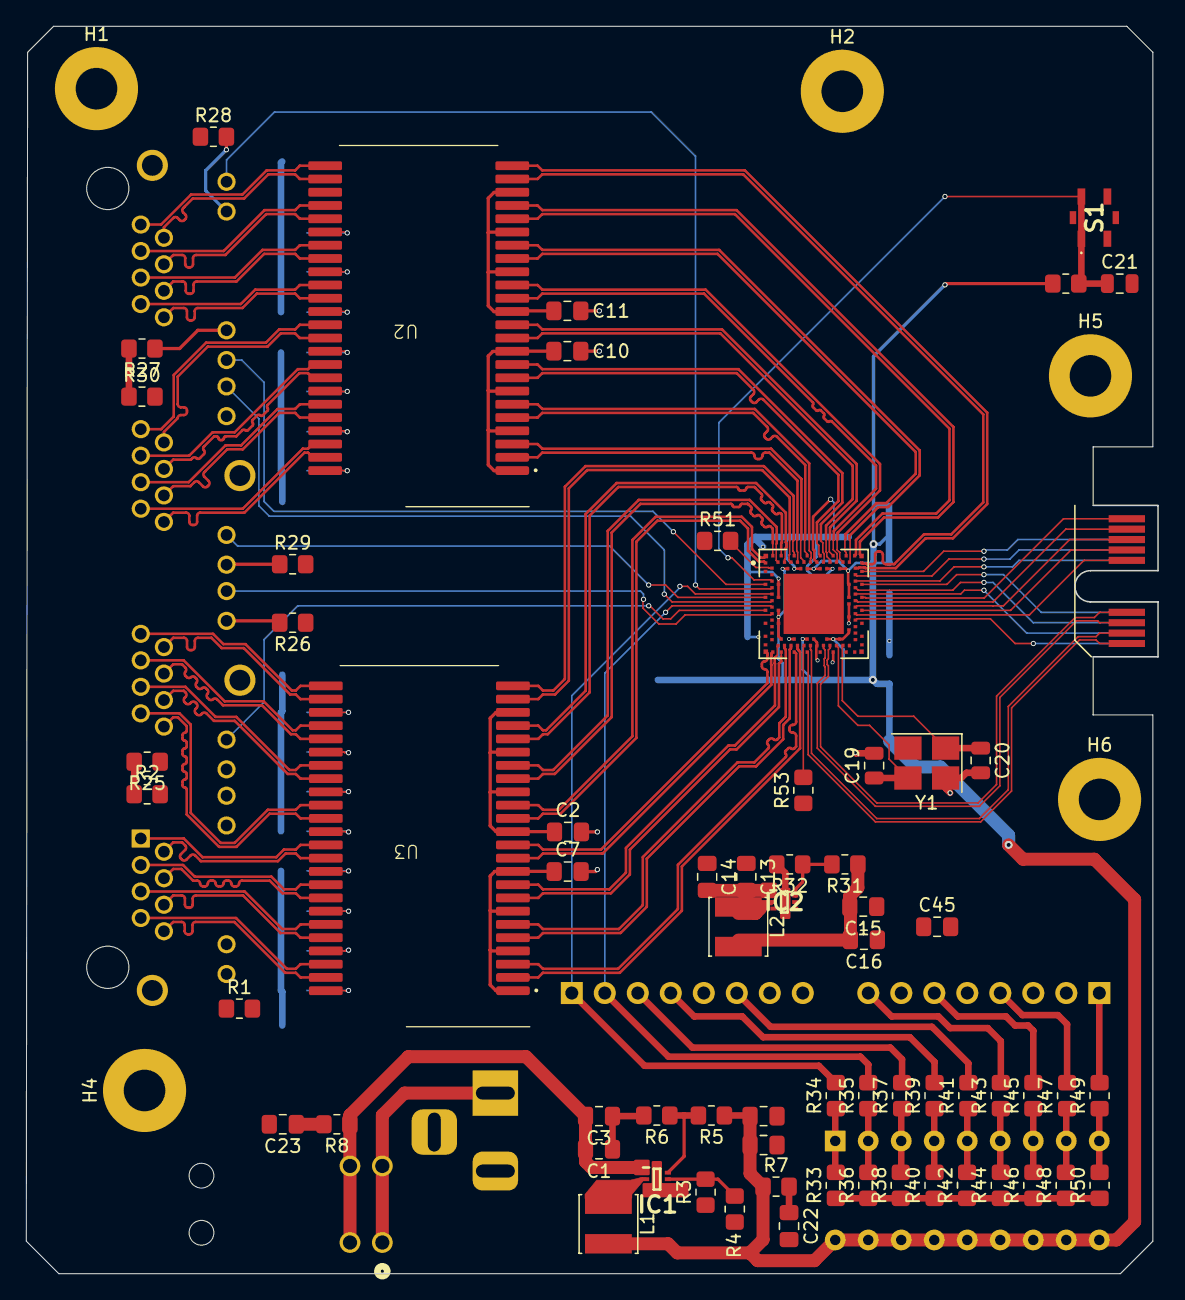
[picture p28: board gsw141-breakout.kicad_pcb from above]

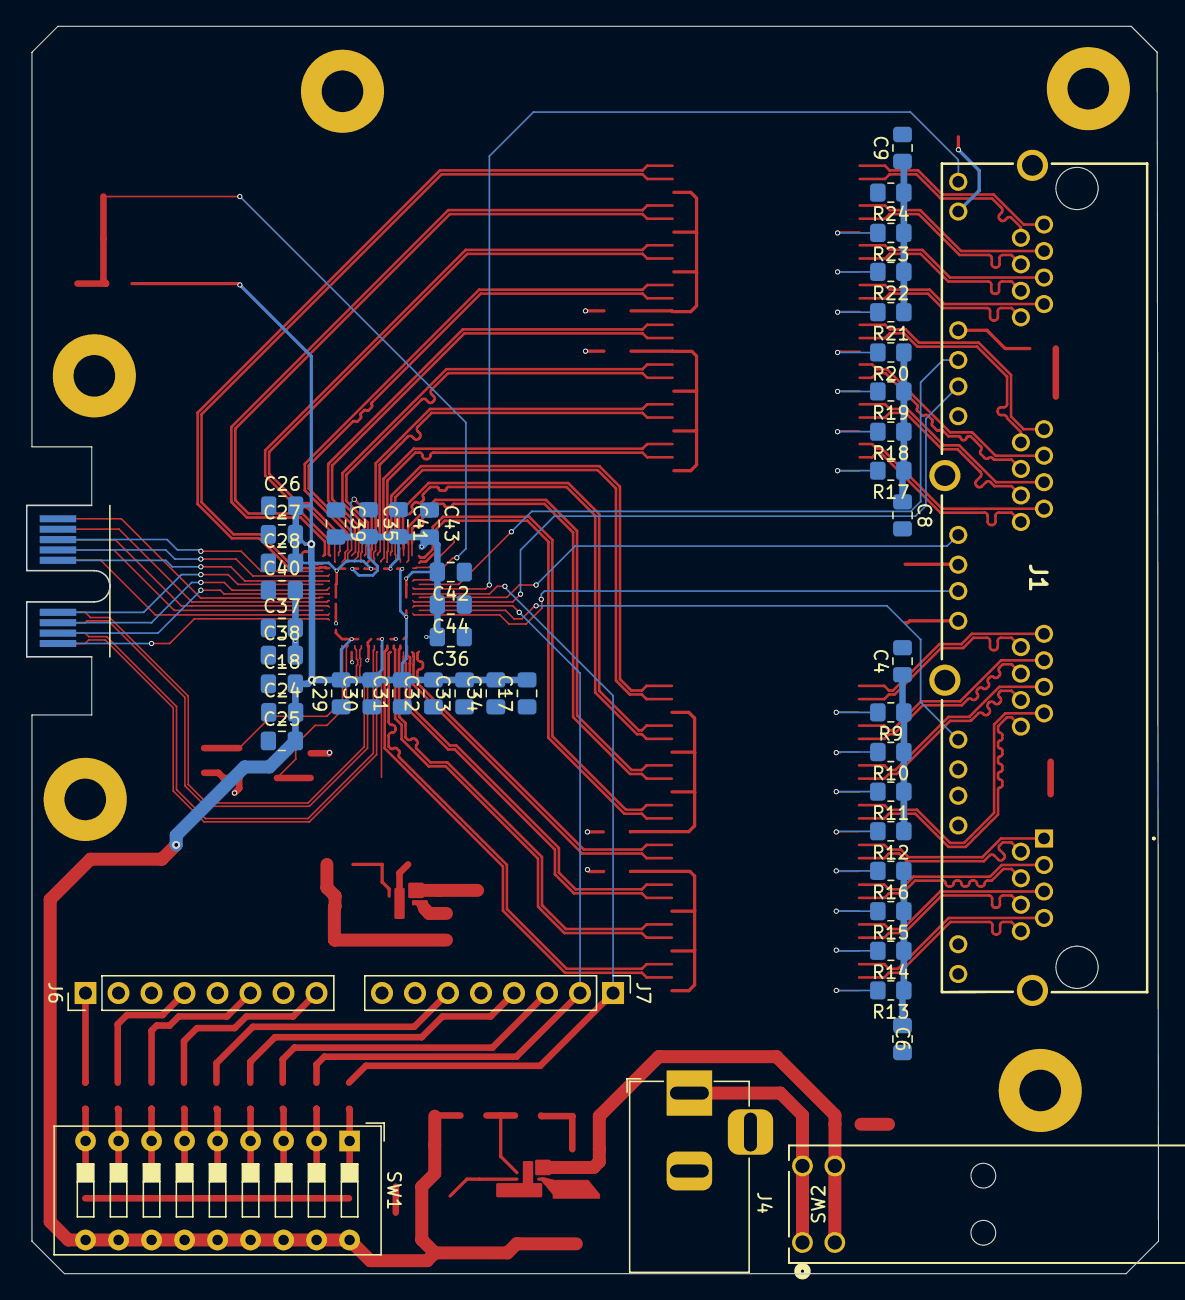
[picture p29: board gsw141-breakout.kicad_pcb from below]

Board: 4 copper layers, 87.1 x 96.0 mm, 119 parts (49 on the bottom side), 165 nets.
