rustbox/router/jtag/md.rs

use alloc::vec::Vec;
use esp_hal::gpio::{AnyFlex, AnyOutput, GpioPin, Level, Pull};
use esp_hal::{
    prelude::*,
    timer::{ErasedTimer, PeriodicTimer},
};
use fugit::HertzU64;
use nb::block;

// Taken from Table 25, page 56 of GPY111 datasheet
const START_FRAME: &[u8] = &[0, 1];
const WRITE_OP: &[u8] = &[0, 1];
const READ_OP: &[u8] = &[1, 0];
const TURNAROUND: u8 = 2;

#[derive(Debug, Clone)]
pub enum Op {
    Read,
    Write,
}

impl Op {
    pub fn signal(&self) -> &[u8] {
        match self {
            Op::Read => READ_OP,
            Op::Write => WRITE_OP,
        }
    }
}

#[derive(Debug, Clone)]
/// PRE: How many cycles of 1s from the controller to be issued before a frame
pub struct MDIOFrame<const PRE: u8 = 2> {
    /// PHY address: This is 5 bits, and we will use bits [4, 0] of the internal u8
    /// when actually transmitting this value
    phy_addr: u8,
    /// Register is the address of the register to read or write to.
    /// Again register is actually only 5 bits, so we use bits [4, 0] of the given u8
    register: u8,
}

impl<const PRE: u8> MDIOFrame<PRE> {
    pub fn new(phy_addr: u8, register: u8) -> MDIOFrame {
        MDIOFrame {
            phy_addr: phy_addr & 0b00011111,
            register: register & 0b00011111,
        }
    }

    pub fn header(&self, op: Op) -> impl IntoIterator<Item = Level>
    where
        [(); PRE as usize]:,
    {
        let pre = [1_u8; PRE as usize];
        let start = START_FRAME;
        let op = op.signal();

        let mut d: Vec<u8> = Vec::new();

        d.extend_from_slice(&pre);
        d.extend_from_slice(start);
        d.extend_from_slice(op);

        // PHY Address
        for b in 0..5 {
            // When b = 0, we want to grab bit 4, to go from high to low
            let h = 4 - b;
            d.push(self.phy_addr >> h & 1);
        }

        // MDIO Register Address
        for b in 0..5 {
            // When b = 0, we want to grab bit 4, to go from high to low
            let h = 4 - b;
            d.push(self.register >> h & 1);
        }

        d.iter()
            .map(|v| {
                // cheese it
                match v & 1 {
                    1 => Level::High,
                    0 => Level::Low,
                    _ => unreachable!(),
                }
            })
            .collect::<Vec<_>>()
    }
}

pub struct Controller<'a> {
    pub clock: PeriodicTimer<ErasedTimer>,
    pub mdc: AnyOutput<'a>,
    pub mdio: GpioPin<0>,

    freq: HertzU64,
}

impl<'a> Controller<'a> {
    pub fn new(
        freq: HertzU64,
        mut clock: PeriodicTimer<ErasedTimer>,
        mdc: GpioPin<1>,
        mut mdio: GpioPin<0>,
    ) -> Controller<'a> {
        clock.start(freq.into_duration() / 2).unwrap();

        let mut mdc = AnyOutput::new(mdc, Level::Low);

        let init = Level::High;
        let pull = Pull::Up;

        let lol = || unsafe { core::mem::transmute(()) };
        mdio.set_output_high(init.into(), lol());
        mdio.internal_pull_down(pull==Pull::Down, lol());
        mdio.internal_pull_up(pull==Pull::Up, lol());
        mdio.set_to_open_drain_output(lol());

        mdc.set_high();

        Controller { clock, mdc, mdio, freq }
    }

    #[link_section = ".rwtext"]
    fn pulse_clock(&mut self) {
        block!(self.clock.wait()).unwrap();
        self.mdc.set_high();
        block!(self.clock.wait()).unwrap();
        self.mdc.set_low();
    }

    #[inline]
    fn set_write_mode(&mut self) {
        self.mdio
            .enable_output(true, unsafe { core::mem::transmute(()) });
    }


    #[inline]
    fn set_read_mode(&mut self) {
        self.mdio.enable_output(false, unsafe { core::mem::transmute(()) });
    }

    #[inline]
    pub fn turnaround(&mut self) {
        for _ in 0..TURNAROUND {
            self.pulse_clock();
        }
    }

    #[inline]
    pub fn write_bit(&mut self, v: Level) {
        // Set the MDIO value
        self.mdio
            .set_output_high(v.into(), unsafe { core::mem::transmute(()) });

        // Clock cycle
        self.pulse_clock();
    }

    pub fn read_bit(&mut self) -> Level {
        let read = self.mdio.is_high().into();

        self.pulse_clock();

        read
    }

    #[link_section = ".rwtext"]
    pub fn frame_read(&mut self, frame: MDIOFrame) -> u16 {
        // Just assert that the frame is a read if we're in the read function
        let header = frame.header(Op::Read);

        self.mdio.set_high();
        self.set_write_mode();
        
        block!(self.clock.wait()).unwrap();
        block!(self.clock.wait()).unwrap(); // else we'll foreshorten the first cycle

        // Write the header bits
        for b in header {
            // println!("W: {:?}", b);
            self.write_bit(b);
        }

        self.set_read_mode();
        self.turnaround();

        let mut value = 0;
        for b in 0..16 {
            // Read bits High to Low
            let h = 15 - b;

            let x: u16 = match self.read_bit() {
                Level::Low => 0,
                Level::High => 1,
            };
            value |= x << h;
        }

        value
    }

    pub fn frame_write(&mut self, frame: MDIOFrame, data: u16) {
        let header = frame.header(Op::Write);

        self.set_write_mode();
        self.clock.clear_interrupt(); // else we'll foreshorten the first cycle

        // Write the header bits
        for b in header {
            self.write_bit(b);
        }

        self.turnaround();

        for b in 0..16 {
            // Write bits high to low
            let h = 15 - b;

            self.write_bit(match data >> h & 1 {
                0 => Level::Low,
                1 => Level::High,

                _ => unreachable!(),
            });
        }
    }
}
