rustbox/router/(commit log)

2024-07-10 init commit of existing gsw breakout kicad files and readme/todo list
    [1149848.stp, HSEC8-109-01-L-RA-TR.step, TPS564247DRLR.stp, TS21-34-035-BK-160-SMT-TR.stp, gsw141-breakout.kicad_pcb, gsw141-breakout.kicad_sch]
2024-08-03 fixup: add kicad .gitignore, delete ignored bits
2024-08-07 latest updates to the GSW breakout
    [gsw141-breakout.kicad_pcb, gsw141-breakout.kicad_sch]
2024-08-07 adding SYZYGY phy breakout board and schematic
    [AP7363-HA-7.stp, GPY111.stp, QTH-020-01-X-D-DP-A.step, SYZYGY-PHY.kicad_pcb, SYZYGY-PHY.kicad_sch]
2024-08-07 fixing diff pair skew from the twisted pair interface
    [SYZYGY-PHY.kicad_pcb]
2024-08-08 fixup: update kicad .gitignore, re-add Cargo.lock
2024-08-08 syzygy todo update
    [SYZYGY-PHY.kicad_pcb]
2024-08-08 wibbly wobbly
    [SYZYGY-PHY.kicad_pcb]
2024-08-09 more length tuning
    [SYZYGY-PHY.kicad_pcb]
2024-08-14 picking a concrete inductor and updating footprint, breakout out MDC/MDIO into headers instead of SYZYGY, corrected rules and text labels
    [SYZYGY-PHY.kicad_pcb, SYZYGY-PHY.kicad_sch]
2024-08-14 adding another mounting hole for a more stable 3 mounts
    [SYZYGY-PHY.kicad_pcb, SYZYGY-PHY.kicad_sch]
2024-08-14 adding GND stippling
    [SYZYGY-PHY.kicad_pcb]
2024-08-14 updating the caps and crystal, confirming the crystal circuit and footprints
    [SYZYGY-PHY.kicad_pcb, SYZYGY-PHY.kicad_sch]
2024-08-15 updating RGMII traces to be wider for 50 ohm target impedance and re-tuning lengths
    [SYZYGY-PHY.kicad_pcb]
2024-08-16 adding level shifter parts to schematic and pcb, rerouted RGMII and mostly length matched each channel
    [SYZYGY-PHY.kicad_pcb, SYZYGY-PHY.kicad_sch]
2024-08-16 adding power indicator LED
    [SYZYGY-PHY.kicad_pcb, SYZYGY-PHY.kicad_sch]
2024-08-16 adding footprint/symbol libraries I forgot earlier
    [TXV0106BQBR.stp]
2024-08-16 update 3d model paths to use variable
    [SYZYGY-PHY.kicad_pcb]
2024-08-16 fixing 3d model orientation
    [SYZYGY-PHY.kicad_pcb]
2024-08-16 misc changes + SYZYGY-PHY fixes
    fix up KiCad paths to be slightly friendlier to sharing between
    machines; assert that we only want to use the library from `../`
    relative so the 3d model path is valid.
    SYZYGY-PHY fixes:
    - add startup RC circuit to hold reset low for >1ms
    - add calibration resistors between PHY C+/- and GND
    - remove VDDLC from 3.3V net in schematic (not fully routed in PCB)
    - update clock to a more frequency stable model, change CL caps accordingly
    [SYZYGY-PHY.kicad_pcb, SYZYGY-PHY.kicad_sch, gsw141-breakout.kicad_pcb]
2024-08-16 fixed power lines, added keepout underneath RJ45, added ground stippling
    [SYZYGY-PHY.kicad_pcb]
2024-08-16 truly the Rx and Tx RGMII channels are length tuned very nearly exactly length tuned
    [SYZYGY-PHY.kicad_pcb]
2024-08-17 adding inductor footprint for 2016 metric sized inductor, and changed L1 footprint and added to the pcb, updated the schematic with the new inductor part and datasheet link
    [SYZYGY-PHY.kicad_pcb, SYZYGY-PHY.kicad_sch]
2024-08-17 do we like more text? Cant stop wont stop editing the board
    [SYZYGY-PHY.kicad_pcb]
2024-08-17 adding a GND header, adding 3.3V and 1.8V 1x2 header
    [SYZYGY-PHY.kicad_pcb, SYZYGY-PHY.kicad_sch]
2024-08-17 make DRC happier with a "solid" connection
    Instead of "thermal relief" where there isn't really room for it,
    connect to the zones by just allowing the fill to pour over the whole
    area.
    [SYZYGY-PHY.kicad_pcb]
2024-08-29 adding SYZYGY breakout board, ready for review
    [SYZYGY-PHY.kicad_pcb, SYZYGY-breakout.kicad_pcb, SYZYGY-breakout.kicad_sch]
2024-08-29 forgot to add qsh symbol and model
    [QSH-020-01-F-D-DP-A.stp, QSH-020-01-X-D-DP-A.step]
2024-08-29 fixing length tuning
    [SYZYGY-breakout.kicad_pcb]
2024-08-30 four layer SYZYGY testing board that breaks out our pinouts for the RGMII interface which connects to the beagleV
    [SYZYGY-RGMII-tester-B_Cu.gbr, SYZYGY-RGMII-tester-B_Mask.gbr, SYZYGY-RGMII-tester-B_Paste.gbr, SYZYGY-RGMII-tester-B_Silkscreen.gbr, SYZYGY-RGMII-tester-Edge_Cuts.gbr, SYZYGY-RGMII-tester-F_Cu.gbr, SYZYGY-RGMII-tester-F_Mask.gbr, SYZYGY-RGMII-tester-F_Paste.gbr]
2024-08-31 feat: add minimal jtag-over-esp32c3 skeleton
2024-09-04 syzygy phy docs
    [SYZYGY-PHY.kicad_pcb]
2024-09-05 updating gitignore and SYZYGY-PHY boards and footprints, and updating README with info on strapping pins and values
    [SYZYGY-PHY.kicad_pcb, SYZYGY-PHY.kicad_sch]
2024-09-06 board updates, length tuning again
    [SYZYGY-PHY.kicad_pcb]
2024-09-13 nfc: add some mouser numbers, quiet some warnings
    Also, updated the RJ45 jack's schematic symbol to show both LEDs in the
    left side.
    NFC=No Functional Changes
    [SYZYGY-PHY.kicad_pcb, SYZYGY-PHY.kicad_sch]
2024-09-18 jtag/mdio code update I guess. increase hole width and clearance to fit with jlcpcb reqs
    [SYZYGY-PHY.kicad_pcb]
2024-09-19 feat: add noline to jtag.rs; tweak SYZYGY-PHY schematic
    [SYZYGY-PHY.kicad_sch]
2024-09-26 obviously put the phy address outside the loop so it doesn't get clobbered every command ooops
    [jtag.rs]
2024-10-01 busted: backwards level shifter
    This snapshot updates the pin assignments such that our TX level shifter
    fails the ERC, and then fixes that by flipping it in the schematic.
    It also pulls all the updated details from the schematic into the
    layout, which does not pass the DRC.
    [SYZYGY-PHY.kicad_pcb, SYZYGY-PHY.kicad_sch]
2024-10-02 flipping the level shifter adding some labels
    [SYZYGY-PHY.kicad_pcb, SYZYGY-PHY.kicad_sch]
2024-10-03 mild board updates before ordering
    [SYZYGY-PHY.kicad_pcb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]
2024-10-03 had to reposition the level shifter by 0.05 mm to the right to not have to buy a new stencil
    [SYZYGY-PHY.kicad_pcb]
