rustbox/router/(notices)

Notices in the files:
HSEC8-109-01-L-RA-TR/HSEC8-109-01-L-RA-TR.step:
author */ ('License CC BY-ND 4.0'),
